e-licktronic/Yocto-V2.0/Eagle/Yocto v2.007.brd

## EAGLE design Eagle/Yocto v2.007.brd (2022-08-23)

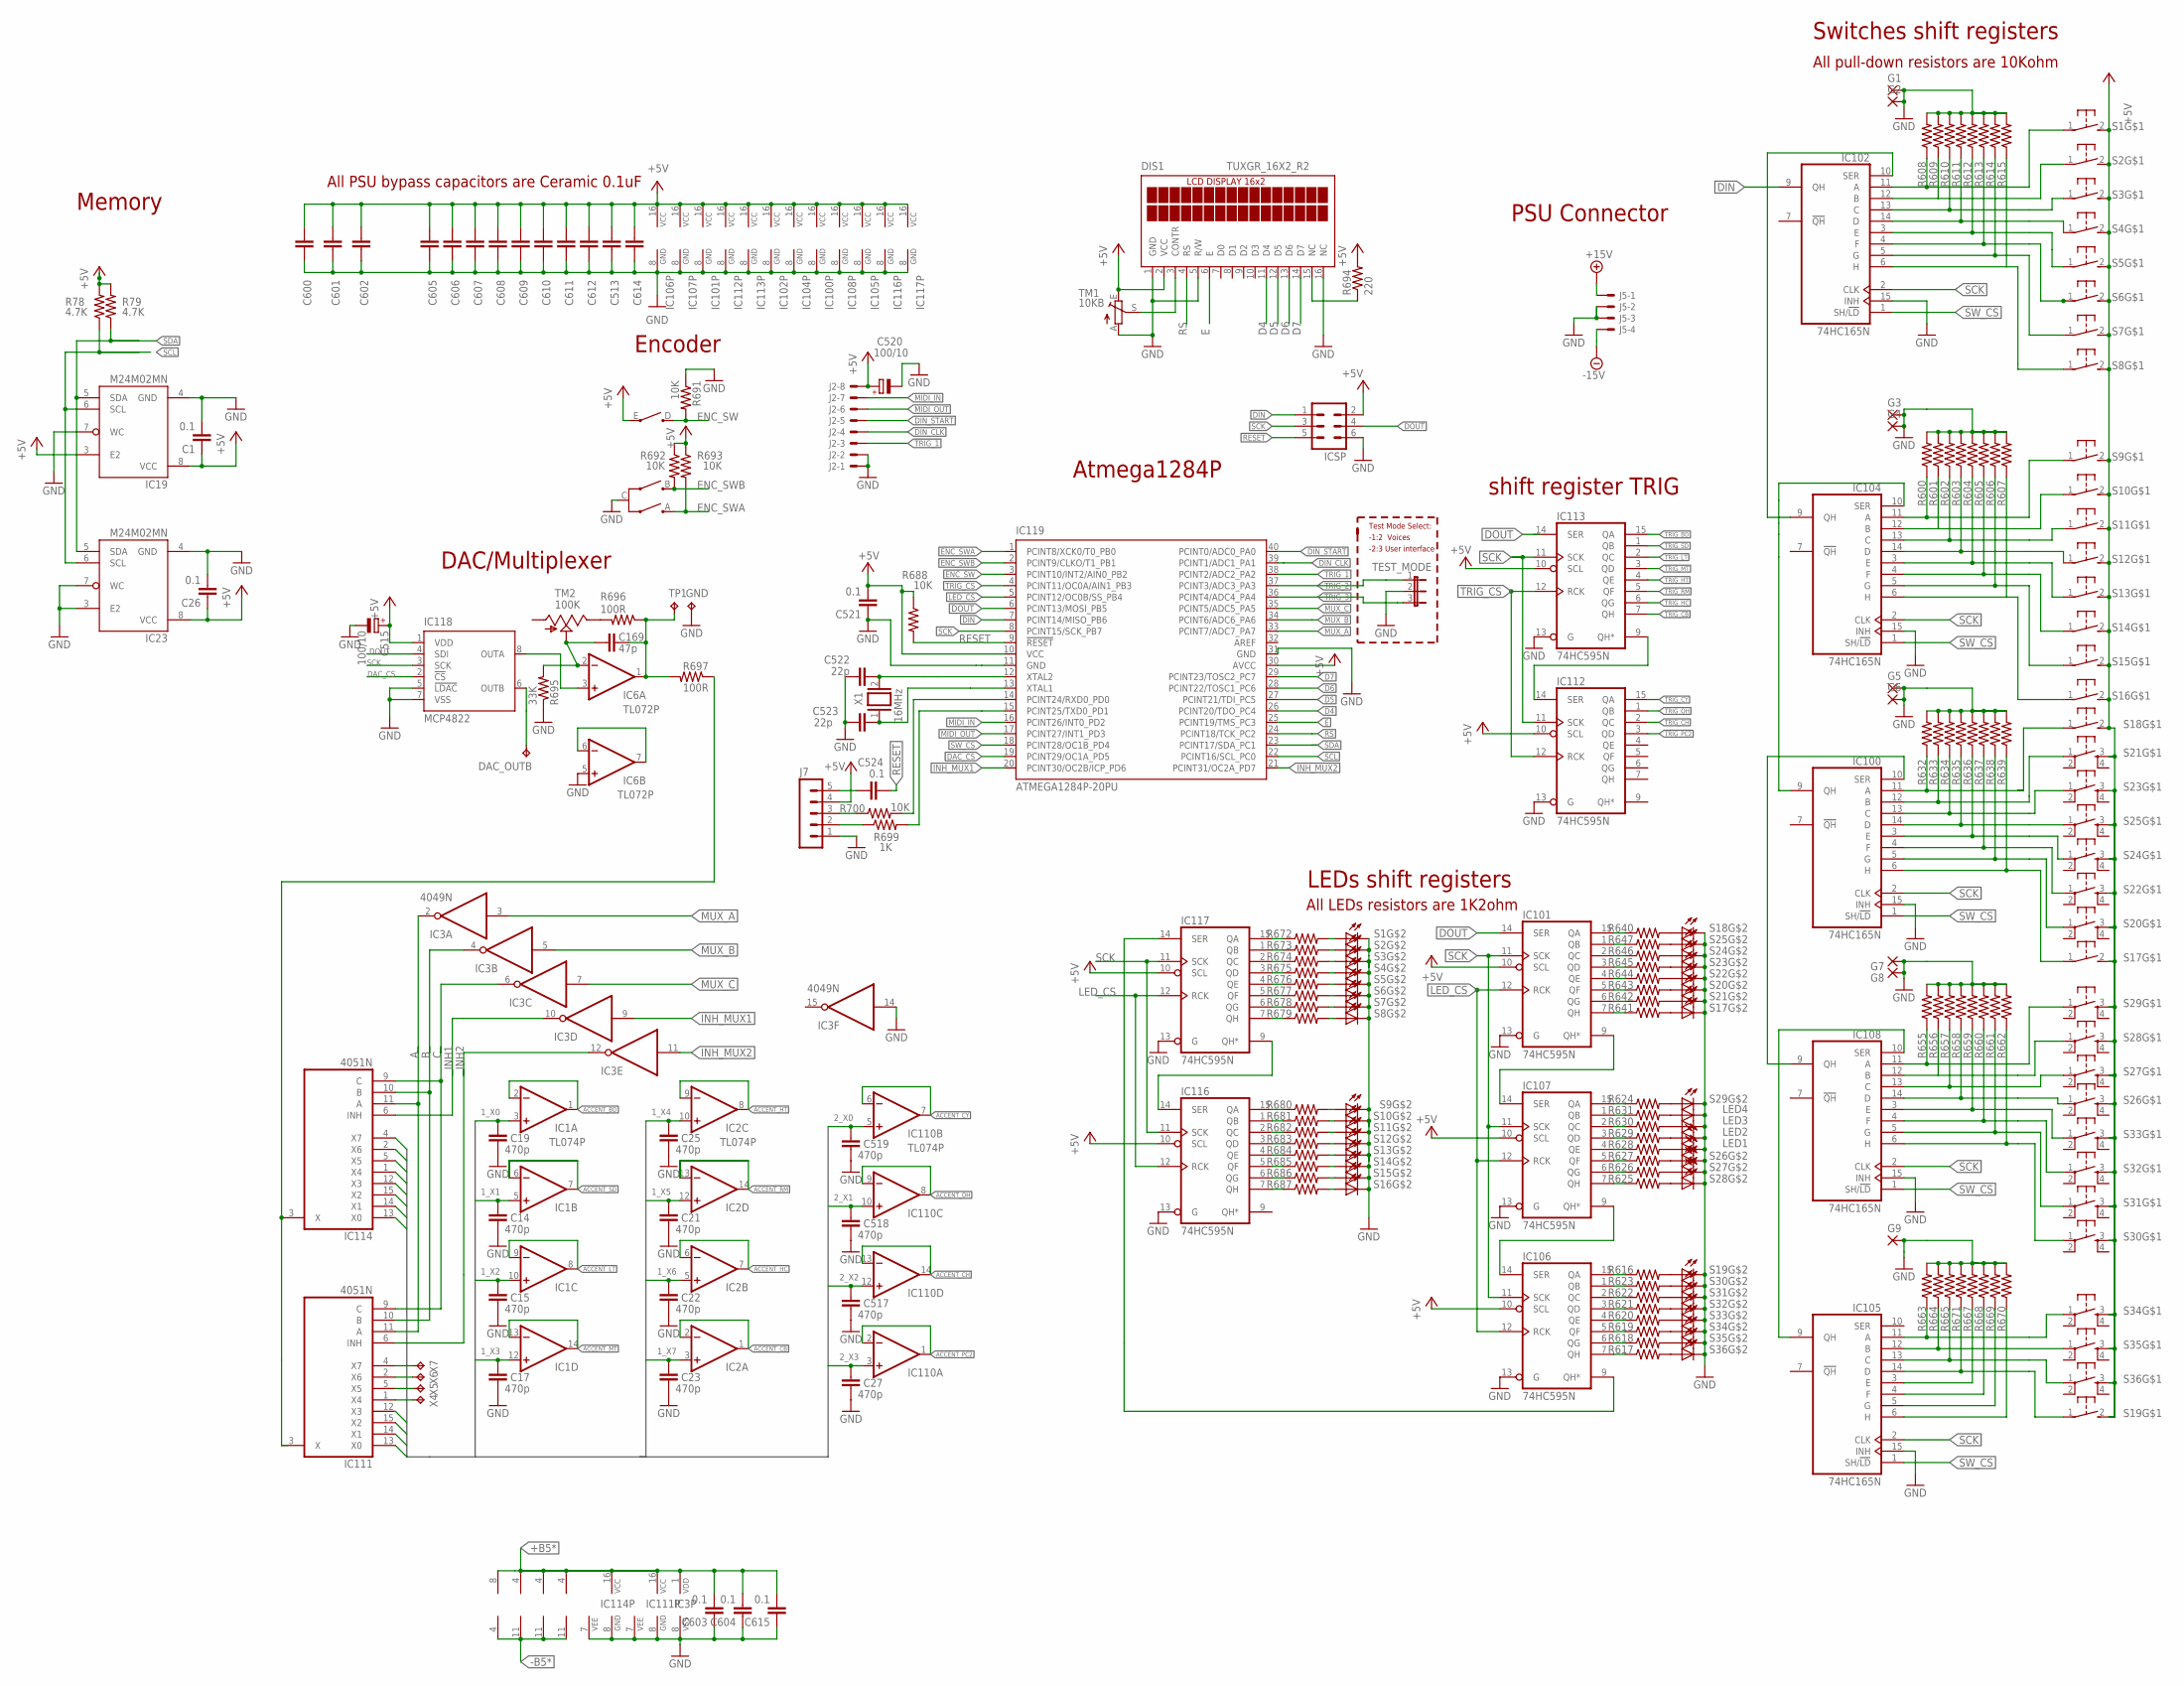
[picture p36: schematic Yocto v2.007.sch, sheet 1, SEQ]

Parts:
C1, C26, C513, C521, C524, C600, C601, C602, C603, C604, C605, C606, C607, C608, C609, C610, C611, C612, C614, C615: 0.1; C050-024X044
C14, C15, C17, C19, C21, C22, C23, C25, C27, C517, C518, C519: 470p; C050-025X075
C169: 47p; C025-025X050
C515, C520: 100/10; E2-5
C522, C523: 22p; C025-025X050
DAC_OUTB: TPB0,8; B0,8
DIS1: TUXGR_16X2_R2
G1, G2, G3, G4, G5, G6, G7, G8, G9: WIREPAD1,6/0,8; 1,6/0,8
GND: TPB0,8; B0,8
IC1, IC2, IC110: TL074P; DIL14
IC3: 4049N; DIL16
IC6: TL072P; DIL08
IC19, IC23: M24M02MN; SO08
IC100, IC102, IC104, IC105, IC108: 74HC165N; DIL16
IC101, IC106, IC107, IC112, IC113, IC116, IC117: 74HC595N; DIL16
IC111, IC114: 4051N; DIL16
IC118: MCP4822; DIL8
IC119: ATMEGA1284P-20PU; DIL40
ICSP: MA03-2
J2: 22-27-2081-08; 6410-08
J5: KK-156-4
J7: MA05-1; MA05-1A
LED1, LED2, LED3, LED4: LED3MM
R78, R79: 4.7K; 0207/7
R600, R601, R602, R603, R604, R605, R606, R607, R608, R609, R610, R611, R612, R613, R614, R615, R632, R633, R634, R635, R636, R637, R638, R639, R655, R656, R657, R658, R659, R660, R661, R662, R663, R664, R665, R667, R668, R669, R670, R671, R688, R691, R692, R693, R700: 10K; 0207/7
R616, R617, R618, R619, R620, R621, R622, R623, R624, R625, R626, R627, R628, R629, R630, R631, R640, R641, R642, R643, R644, R645, R646, R647, R672, R673, R674, R675, R676, R677, R678, R679, R680, R681, R682, R683, R684, R685, R686, R687: 1.2K; 0207/7
R694: 220; 0207/7
R695: 33K; 0207/7
R696, R697: 100R; 0207/7
R699: 1K; 0207/7
S1, S2, S3, S4, S5, S6, S7, S8, S9, S10, S11, S12, S13, S14, S15, S16, S17, S18, S19: MX1A_CHERRY_SW_LED"; MX1A-SW
S20, S21, S22, S23, S24, S25, S26, S27, S28, S29, S30, S31, S32, S33, S34, S35, S36: ZTSN_SW_LED"; SPH_SW
TEST_MODE: JP2E; JP2
TM1: 10KB; CT6
TM2: 100K; S64W
TP1: TPB0,8; B0,8
VR29: PEC16_ENCODER
X1: 16MHz; QS
X4, X5, X6, X7: TPB0,8; B0,8

Connections:
1_X0: C19.1, IC1.3 (+IN), IC114.13 (X0)
1_X1: C14.1, IC1.5 (+IN), IC114.14 (X1)
1_X2: C15.1, IC1.10 (+IN), IC114.15 (X2)
1_X3: C17.1, IC1.12 (+IN), IC114.12 (X3)
1_X4: C25.1, IC2.10 (+IN), IC114.1 (X4)
1_X5: C21.1, IC2.12 (+IN), IC114.5 (X5)
1_X6: C22.1, IC2.5 (+IN), IC114.2 (X6)
1_X7: C23.1, IC2.3 (+IN), IC114.4 (X7)
2_X0: C519.1, IC110.5 (+IN), IC111.13 (X0)
2_X1: C518.1, IC110.10 (+IN), IC111.14 (X1)
2_X2: C517.1, IC110.12 (+IN), IC111.15 (X2)
2_X3: C27.1, IC110.3 (+IN), IC111.12 (X3)
+5V: C1.1, C26.1, C513.2, C515.+, C520.+, C521.2, C600.2, C601.2, C602.2, C605.2, C606.2, C607.2, C608.2, C609.2, C610.2, C611.2, C612.2, C614.2, DIS1.2 (VCC), IC19.3 (E2), IC19.8 (VCC), IC23.8 (VCC), IC100.16 (VCC), IC101.10 (SCL), IC101.16 (VCC), IC102.16 (VCC), IC104.16 (VCC), IC105.16 (VCC), IC106.10 (SCL), IC106.16 (VCC), IC107.10 (SCL), IC107.16 (VCC), IC108.16 (VCC), IC112.10 (SCL), IC112.16 (VCC), IC113.10 (SCL), IC113.16 (VCC), IC116.10 (SCL), IC116.16 (VCC), IC117.10 (SCL), IC117.16 (VCC), IC118.1 (VDD), IC119.10 (VCC), IC119.30 (AVCC), ICSP.2, J2.8, J7.4, R78.2, R79.2, R688.1, R692.1, R693.1, R694.2, S1.2 (S), S2.2 (S), S3.2 (S), S4.2 (S), S5.2 (S), S6.2 (S), S7.2 (S), S8.2 (S), S9.2 (S), S10.2 (S), S11.2 (S), S12.2 (S), S13.2 (S), S14.2 (S), S15.2 (S), S16.2 (S), S17.2 (S), S18.2 (S), S19.2 (S), S20.3 (S), S21.3 (S), S22.3 (S), S23.3 (S), S24.3 (S), S25.3 (S), S26.3 (S), S27.3 (S), S28.3 (S), S29.3 (S), S30.3 (S), S31.3 (S), S32.3 (S), S33.3 (S), S34.3 (S), S35.3 (S), S36.3 (S), TM1.E, VR29.E; also elsewhere on the board
+15V: J5.1; also elsewhere on the board
+B5*: C603.2, C604.2, C615.2, IC1.4 (V+), IC2.4 (V+), IC3.1 (VDD), IC6.8 (V+), IC110.4 (V+), IC111.16 (VCC), IC114.16 (VCC); also elsewhere on the board
-15V: J5.4; also elsewhere on the board
-B5*: IC1.11 (V-), IC2.11 (V-), IC6.4 (V-), IC110.11 (V-); also elsewhere on the board
A: IC3.2 (O), IC111.11 (A), IC114.11 (A)
ACCENT_BD: IC1.1 (OUT), IC1.2 (-IN); also elsewhere on the board
ACCENT_CB: IC2.1 (OUT), IC2.2 (-IN); also elsewhere on the board
ACCENT_CH: IC110.13 (-IN), IC110.14 (OUT); also elsewhere on the board
ACCENT_CY: IC110.6 (-IN), IC110.7 (OUT); also elsewhere on the board
ACCENT_HC: IC2.6 (-IN), IC2.7 (OUT); also elsewhere on the board
ACCENT_HT: IC2.8 (OUT), IC2.9 (-IN); also elsewhere on the board
ACCENT_LT: IC1.8 (OUT), IC1.9 (-IN); also elsewhere on the board
ACCENT_MT: IC1.13 (-IN), IC1.14 (OUT); also elsewhere on the board
ACCENT_OH: IC110.8 (OUT), IC110.9 (-IN); also elsewhere on the board
ACCENT_PC2: IC110.1 (OUT), IC110.2 (-IN); also elsewhere on the board
ACCENT_RM: IC2.13 (-IN), IC2.14 (OUT); also elsewhere on the board
ACCENT_SD: IC1.6 (-IN), IC1.7 (OUT); also elsewhere on the board
B: IC3.4 (O), IC111.10 (B), IC114.10 (B)
C: IC3.6 (O), IC111.9 (C), IC114.9 (C)
D4: DIS1.11 (D4), IC119.26 (PCINT20/TDO_PC4)
D5: DIS1.12 (D5), IC119.27 (PCINT21/TDI_PC5)
D6: DIS1.13 (D6), IC119.28 (PCINT22/TOSC1_PC6)
D7: DIS1.14 (D7), IC119.29 (PCINT23/TOSC2_PC7)
DAC_CS: IC118.2 (!CS!), IC119.19 (PCINT29/OC1A_PD5)
DIN: IC102.9 (QH), IC119.7 (PCINT14/MISO_PB6), ICSP.1
DIN_CLK: IC119.39 (PCINT1/ADC1_PA1), J2.4
DIN_START: IC119.40 (PCINT0/ADC0_PA0), J2.5
DOUT: IC101.14 (SER), IC113.14 (SER), IC118.4 (SDI), IC119.6 (PCINT13/MOSI_PB5), ICSP.4
E: DIS1.6 (E), IC119.25 (PCINT19/TMS_PC3)
ENC_SW: IC119.3 (PCINT10/INT2/AIN0_PB2), R691.2, VR29.D
ENC_SWA: IC119.1 (PCINT8/XCK0/T0_PB0), R693.2, VR29.A
ENC_SWB: IC119.2 (PCINT9/CLKO/T1_PB1), R692.2, VR29.B
GND: C1.2, C14.2, C15.2, C17.2, C19.2, C21.2, C22.2, C23.2, C25.2, C26.2, C27.2, C513.1, C515.-, C517.2, C518.2, C519.2, C520.-, C521.1, C522.1, C523.1, C600.1, C601.1, C602.1, C603.1, C604.1, C605.1, C606.1, C607.1, C608.1, C609.1, C610.1, C611.1, C612.1, C614.1, C615.1, DIS1.1 (GND), DIS1.5 (R/W), DIS1.16 (NC), G1.1, G2.1, G3.1, G4.1, G5.1, G6.1, G7.1, G8.1, G9.1, GND.P$1, IC3.8 (VSS), IC3.14 (I), IC6.5 (+IN), IC19.4 (GND), IC19.7 (WC), IC23.3 (E2), IC23.4 (GND), IC23.7 (WC), IC100.8 (GND), IC100.15 (INH), IC101.8 (GND), IC101.13 (G), IC102.8 (GND), IC102.15 (INH), IC104.8 (GND), IC104.15 (INH), IC105.8 (GND), IC105.15 (INH), IC106.8 (GND), IC106.13 (G), IC107.8 (GND), IC107.13 (G), IC108.8 (GND), IC108.15 (INH), IC111.7 (VEE), IC111.8 (GND), IC112.8 (GND), IC112.13 (G), IC113.8 (GND), IC113.13 (G), IC114.7 (VEE), IC114.8 (GND), IC116.8 (GND), IC116.13 (G), IC117.8 (GND), IC117.13 (G), IC118.5 (!LDAC!), IC118.7 (VSS), IC119.11 (GND), IC119.31 (GND), ICSP.6, J2.1, J2.2, J5.2, J5.3, J7.1, LED1.K (C), LED2.K (C), LED3.K (C), LED4.K (C), R600.2, R601.2, R602.2, R603.2, R604.2, R605.2, R606.2, R607.2, R608.2, R609.2, R610.2, R611.2, R612.2, R613.2, R614.2, R615.2, R632.2, R633.2, R634.2, R635.2, R636.2, R637.2, R638.2, R639.2, R655.2, R656.2, R657.2, R658.2, R659.2, R660.2, R661.2, R662.2, R663.2, R664.2, R665.2, R667.2, R668.2, R669.2, R670.2, R671.2, R691.1, R695.1, S1.K (C), S2.K (C), S3.K (C), S4.K (C), S5.K (C), S6.K (C), S7.K (C), S8.K (C), S9.K (C), S10.K (C), S11.K (C), S12.K (C), S13.K (C), S14.K (C), S15.K (C), S16.K (C), S17.K (C), S18.K (C), S19.K (C), S20.K (C), S21.K (C), S22.K (C), S23.K (C), S24.K (C), S25.K (C), S26.K (C), S27.K (C), S28.K (C), S29.K (C), S30.K (C), S31.K (C), S32.K (C), S33.K (C), S34.K (C), S35.K (C), S36.K (C), TEST_MODE.2, TM1.A, VR29.C; also elsewhere on the board
INH1: IC3.10 (O), IC114.6 (INH)
INH2: IC3.12 (O), IC111.6 (INH)
INH_MUX1: IC3.9 (I), IC119.20 (PCINT30/OC2B/ICP_PD6)
INH_MUX2: IC3.11 (I), IC119.21 (PCINT31/OC2A_PD7)
LED_CS: IC101.12 (RCK), IC106.12 (RCK), IC107.12 (RCK), IC116.12 (RCK), IC117.12 (RCK), IC119.5 (PCINT12/OC0B/SS_PB4)
MIDI_IN: IC119.16 (PCINT26/INT0_PD2), J2.7
MIDI_OUT: IC119.17 (PCINT27/INT1_PD3), J2.6
MUX_A: IC3.3 (I), IC119.33 (PCINT7/ADC7_PA7)
MUX_B: IC3.5 (I), IC119.34 (PCINT6/ADC6_PA6)
MUX_C: IC3.7 (I), IC119.35 (PCINT5/ADC5_PA5)
unnamed: R624.2, S29.A
unnamed: R625.2, S28.A
unnamed: R626.2, S27.A
unnamed: R627.2, S26.A
unnamed: R647.2, S25.A
unnamed: R646.2, S24.A
unnamed: R645.2, S23.A
unnamed: R644.2, S22.A
unnamed: R642.2, S21.A
unnamed: R643.2, S20.A
unnamed: R640.2, S18.A
unnamed: R641.2, S17.A
unnamed: LED4.A, R631.2
unnamed: LED3.A, R630.2
unnamed: LED2.A, R629.2
unnamed: LED1.A, R628.2
unnamed: R616.2, S19.A
unnamed: R617.2, S36.A
unnamed: R618.2, S35.A
unnamed: R619.2, S34.A
unnamed: R620.2, S33.A
unnamed: R621.2, S32.A
unnamed: R622.2, S31.A
unnamed: R623.2, S30.A
unnamed: IC108.14 (D), R658.1, S26.1
unnamed: IC6.3 (+IN), IC118.8 (OUTA)
unnamed: IC117.15 (QA), R672.1
unnamed: IC117.1 (QB), R673.1
unnamed: IC117.2 (QC), R674.1
unnamed: IC117.3 (QD), R675.1
unnamed: IC117.4 (QE), R676.1
unnamed: IC117.5 (QF), R677.1
unnamed: IC117.6 (QG), R678.1
unnamed: IC117.7 (QH), R679.1
unnamed: IC116.14 (SER), IC117.9 (QH*)
unnamed: IC116.15 (QA), R680.1
unnamed: IC116.1 (QB), R681.1
unnamed: IC116.2 (QC), R682.1
unnamed: IC116.3 (QD), R683.1
unnamed: IC116.4 (QE), R684.1
unnamed: IC116.5 (QF), R685.1
unnamed: IC116.6 (QG), R686.1
unnamed: IC116.7 (QH), R687.1
unnamed: R680.2, S9.A
unnamed: R681.2, S10.A
unnamed: R682.2, S11.A
unnamed: R683.2, S12.A
unnamed: R684.2, S13.A
unnamed: R685.2, S14.A
unnamed: R686.2, S15.A
unnamed: R687.2, S16.A
unnamed: R672.2, S1.A
unnamed: R673.2, S2.A
unnamed: R674.2, S3.A
unnamed: R675.2, S4.A
unnamed: R676.2, S5.A
unnamed: R677.2, S6.A
unnamed: R678.2, S7.A
unnamed: R679.2, S8.A
unnamed: IC106.9 (QH*), IC117.14 (SER)
unnamed: IC6.6 (-IN), IC6.7 (OUT)
unnamed: IC119.15 (PCINT25/TXD0_PD1), R699.2
unnamed: IC119.14 (PCINT24/RXD0_PD0), R700.2
unnamed: IC112.14 (SER), IC113.9 (QH*)
unnamed: C522.2, IC119.12 (XTAL2), X1.2
unnamed: C523.2, IC119.13 (XTAL1), X1.1
unnamed: IC111.1 (X4), X4.P$1
unnamed: IC111.5 (X5), X5.P$1
unnamed: IC111.2 (X6), X6.P$1
unnamed: IC111.4 (X7), X7.P$1
unnamed: IC102.11 (A), R608.1, S1.1
unnamed: IC102.12 (B), R609.1, S2.1
unnamed: IC102.13 (C), R610.1, S3.1
unnamed: IC102.14 (D), R611.1, S4.1
unnamed: IC102.3 (E), R612.1, S5.1
unnamed: IC102.4 (F), R613.1, S6.1
unnamed: IC102.5 (G), R614.1, S7.1
unnamed: IC102.6 (H), R615.1, S8.1
unnamed: IC104.11 (A), R600.1, S9.1
unnamed: IC104.12 (B), R601.1, S10.1
unnamed: IC104.13 (C), R602.1, S11.1
unnamed: IC104.14 (D), R603.1, S12.1
unnamed: IC104.3 (E), R604.1, S13.1
unnamed: IC104.4 (F), R605.1, S14.1
unnamed: IC104.5 (G), R606.1, S15.1
unnamed: IC104.6 (H), R607.1, S16.1
unnamed: IC100.11 (A), R632.1, S18.1
unnamed: IC100.12 (B), R633.1, S21.1
unnamed: IC100.13 (C), R634.1, S23.1
unnamed: IC100.14 (D), R635.1, S25.1
unnamed: IC100.3 (E), R636.1, S24.1
unnamed: IC100.4 (F), R637.1, S22.1
unnamed: IC100.5 (G), R638.1, S20.1
unnamed: IC102.10 (SER), IC104.9 (QH)
unnamed: IC100.9 (QH), IC104.10 (SER)
unnamed: IC100.6 (H), R639.1, S17.1
unnamed: IC111.3 (X), IC114.3 (X), R697.1
unnamed: IC101.15 (QA), R640.1
unnamed: IC100.10 (SER), IC108.9 (QH)
unnamed: IC108.11 (A), R655.1, S29.1
unnamed: IC108.12 (B), R656.1, S28.1
unnamed: IC108.13 (C), R657.1, S27.1
unnamed: IC108.3 (E), R659.1, S33.1
unnamed: IC108.4 (F), R660.1, S32.1
unnamed: IC108.5 (G), R661.1, S31.1
unnamed: IC108.6 (H), R662.1, S30.1
unnamed: IC101.1 (QB), R647.1
unnamed: IC105.9 (QH), IC108.10 (SER)
unnamed: IC101.2 (QC), R646.1
unnamed: IC105.11 (A), R663.1, S34.1
unnamed: IC105.12 (B), R664.1, S35.1
unnamed: IC105.13 (C), R665.1, S36.1
unnamed: IC105.14 (D), R671.1, S19.1
unnamed: IC105.3 (E), R667.1
unnamed: IC105.4 (F), R668.1
unnamed: IC105.5 (G), R669.1
unnamed: IC105.6 (H), R670.1
unnamed: IC101.3 (QD), R645.1
unnamed: IC101.4 (QE), R644.1
unnamed: IC101.5 (QF), R643.1
unnamed: IC101.6 (QG), R642.1
unnamed: IC101.7 (QH), R641.1
unnamed: IC107.15 (QA), R624.1
unnamed: IC107.1 (QB), R631.1
unnamed: IC107.2 (QC), R630.1
unnamed: IC107.3 (QD), R629.1
unnamed: IC107.4 (QE), R628.1
unnamed: IC107.5 (QF), R627.1
unnamed: IC107.6 (QG), R626.1
unnamed: IC107.7 (QH), R625.1
unnamed: IC101.9 (QH*), IC107.14 (SER)
unnamed: IC106.14 (SER), IC107.9 (QH*)
unnamed: IC106.15 (QA), R616.1
unnamed: IC106.1 (QB), R623.1
unnamed: IC106.2 (QC), R622.1
unnamed: IC106.3 (QD), R621.1
unnamed: IC106.4 (QE), R620.1
unnamed: IC106.5 (QF), R619.1
unnamed: IC106.6 (QG), R618.1
unnamed: IC106.7 (QH), R617.1
unnamed: R696.2, TM2.E
unnamed: C169.2, IC6.1 (OUT), R696.1, R697.2, TP1.P$1
unnamed: C169.1, IC6.2 (-IN), R695.2, TM2.S
unnamed: DIS1.15 (NC), R694.1
unnamed: DIS1.3 (CONTR), TM1.S
unnamed: C524.2, J7.5
unnamed: J7.3, R700.1
unnamed: J7.2, R699.1
RESET: C524.1, IC119.9 (!RESET), ICSP.5, R688.2
RS: DIS1.4 (RS), IC119.24 (PCINT18/TCK_PC2)
SCK: IC100.2 (CLK), IC101.11 (SCK), IC102.2 (CLK), IC104.2 (CLK), IC105.2 (CLK), IC106.11 (SCK), IC107.11 (SCK), IC108.2 (CLK), IC112.11 (SCK), IC113.11 (SCK), IC116.11 (SCK), IC117.11 (SCK), IC118.3 (SCK), IC119.8 (PCINT15/SCK_PB7), ICSP.3
SCL: IC19.6 (SCL), IC23.6 (SCL), IC119.22 (PCINT16/SCL_PC0), R78.1
SDA: IC19.5 (SDA), IC23.5 (SDA), IC119.23 (PCINT17/SDA_PC1), R79.1
SW_CS: IC100.1 (SH/!LD), IC102.1 (SH/!LD), IC104.1 (SH/!LD), IC105.1 (SH/!LD), IC108.1 (SH/!LD), IC119.18 (PCINT28/OC1B_PD4)
TRIG_1: IC119.38 (PCINT2/ADC2_PA2), J2.3
TRIG_2: IC119.37 (PCINT3/ADC3_PA3), TEST_MODE.1
TRIG_3: IC119.36 (PCINT4/ADC4_PA4), TEST_MODE.3
TRIG_BD: IC113.15 (QA); also elsewhere on the board
TRIG_CB: IC113.7 (QH); also elsewhere on the board
TRIG_CH: IC112.2 (QC); also elsewhere on the board
TRIG_CS: IC112.12 (RCK), IC113.12 (RCK), IC119.4 (PCINT11/OC0A/AIN1_PB3)
TRIG_CY: IC112.15 (QA); also elsewhere on the board
TRIG_HC: IC113.6 (QG); also elsewhere on the board
TRIG_HT: IC113.4 (QE); also elsewhere on the board
TRIG_LT: IC113.2 (QC); also elsewhere on the board
TRIG_MT: IC113.3 (QD); also elsewhere on the board
TRIG_OH: IC112.1 (QB); also elsewhere on the board
TRIG_PC2: IC112.3 (QD); also elsewhere on the board
TRIG_RM: IC113.5 (QF); also elsewhere on the board
TRIG_SD: IC113.1 (QB); also elsewhere on the board
WN1: DAC_OUTB.P$1, IC118.6 (OUTB)

Notes on the sheet:
Memory
Encoder
Atmega1284P
DAC/Multiplexer
LEDs shift registers
shift register TRIG
Switches shift registers
PSU Connector
All pull-down resistors are 10Kohm
All PSU bypass capacitors are Ceramic 0.1uF
All LEDs resistors are 1K2ohm
Test Mode Select:
-1:2 Voices
-2:3 User interface

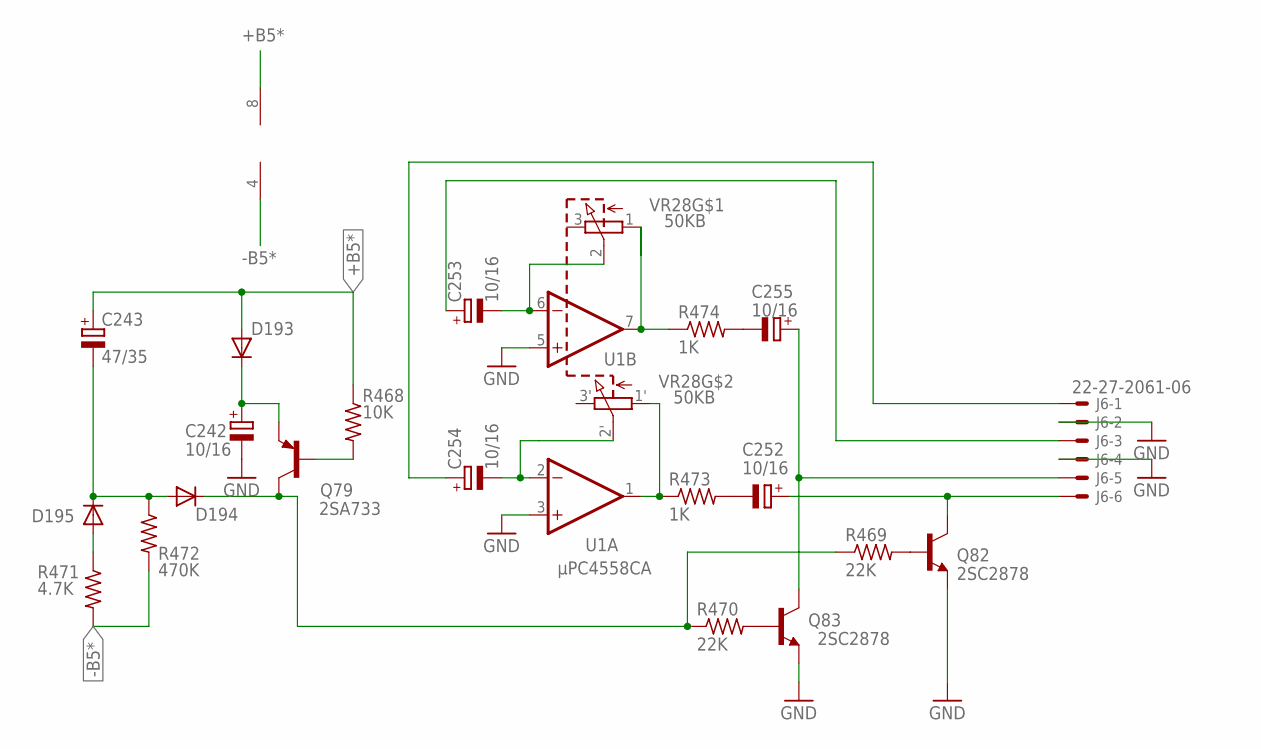
[picture p37: schematic Yocto v2.007.sch, sheet 2, Master]

Parts:
C242, C252, C253, C254, C255: 10/16; E2-5
C243: 47/35; E2,5-6
D193, D194, D195: 1N4148; DO35-7C
J6: 22-27-2061-06; 6410-06
Q79: 2SA733; TO-92-ECB-MARKED
Q82, Q83: 2SC2878; TO92-ECB
R468: 10K; 0207/7
R469, R470: 22K; 0207/7
R471: 4.7K; 0207/7
R472: 470K; 0207/7
R473, R474: 1K; 0207/7
U1: µPC4558CA; DIL08
VR28: 50KB; PTV112-4

Connections:
+B5*: C243.+, D193.A, R468.1, U1.8 (V+); also elsewhere on the board
-B5*: R471.2, R472.2, U1.4 (V-); also elsewhere on the board
GND: C242.-, J6.2, J6.4, Q82.E, Q83.E, U1.3 (+IN), U1.5 (+IN); also elsewhere on the board
unnamed: D195.A, R471.1
unnamed: C243.-, D194.A, D195.C, R472.1
unnamed: R474.1, U1.7 (OUT), VR28.1
unnamed: R473.1, U1.1 (OUT), VR28.1' (1)
unnamed: D194.C, Q79.C, R469.1, R470.1
unnamed: C242.+, D193.C, Q79.E
unnamed: Q79.B, R468.2
unnamed: C254.-, U1.2 (-IN), VR28.2' (2)
unnamed: C253.-, U1.6 (-IN), VR28.2
unnamed: C255.-, R474.2
unnamed: C252.-, R473.2
unnamed: Q82.B, R469.2
unnamed: Q83.B, R470.2
unnamed: C253.+, J6.3
unnamed: C255.+, J6.5, Q83.C
unnamed: C252.+, J6.6, Q82.C
unnamed: C254.+, J6.1

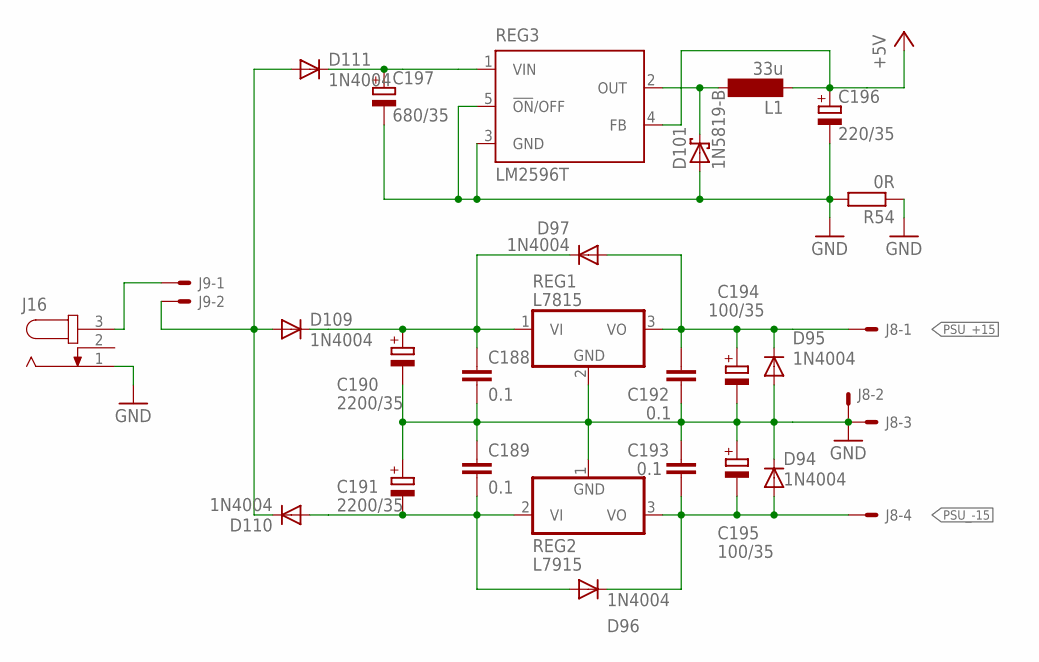
[picture p38: schematic Yocto v2.007.sch, sheet 3, PSU]

Parts:
C188, C189, C192, C193: 0.1; C050-024X044
C190, C191: 2200/35; E7,5-16
C194, C195: 100/35; E3,5-8
C196: 220/35; E3,5-8
C197: 680/35; E5-13
D94, D95, D96, D97, D109, D110, D111: 1N4004; DO41-7
D101: 1N5819-B; DO41-7.6
J8: KK-156-4
J9: KK-156-2
J16: JACK-PLUG0; JACK_PSU_2.1MM
L1: 33u; BS11
R54: 0R; 0207/7
REG1: L7815; TO220V
REG2: L7915; TO220V
REG3: LM2596T; T05D

Connections:
+5V: C196.+, L1.1, REG3.4 (FB); also elsewhere on the board
GND: C188.2, C189.1, C190.-, C191.+, C192.2, C193.1, C194.-, C195.+, C196.-, C197.-, D94.C, D95.A, D101.A, J8.2, J8.3, J16.1, R54.1, R54.2, REG1.2 (GND), REG2.1 (GND), REG3.3 (GND), REG3.5 (!ON!/OFF); also elsewhere on the board
unnamed: C189.2, C191.-, D96.A, D110.A, REG2.2 (VI)
unnamed: C188.1, C190.+, D97.C, D109.C, REG1.1 (VI)
unnamed: D109.A, D110.C, D111.A, J9.2
unnamed: C197.+, D111.C, REG3.1 (VIN)
unnamed: D101.C, L1.2, REG3.2 (OUT)
unnamed: J9.1, J16.3
PSU_+15: C192.1, C194.+, D95.C, D97.A, J8.1, REG1.3 (VO); also elsewhere on the board
PSU_-15: C193.2, C195.-, D94.A, D96.C, J8.4, REG2.3 (VO); also elsewhere on the board

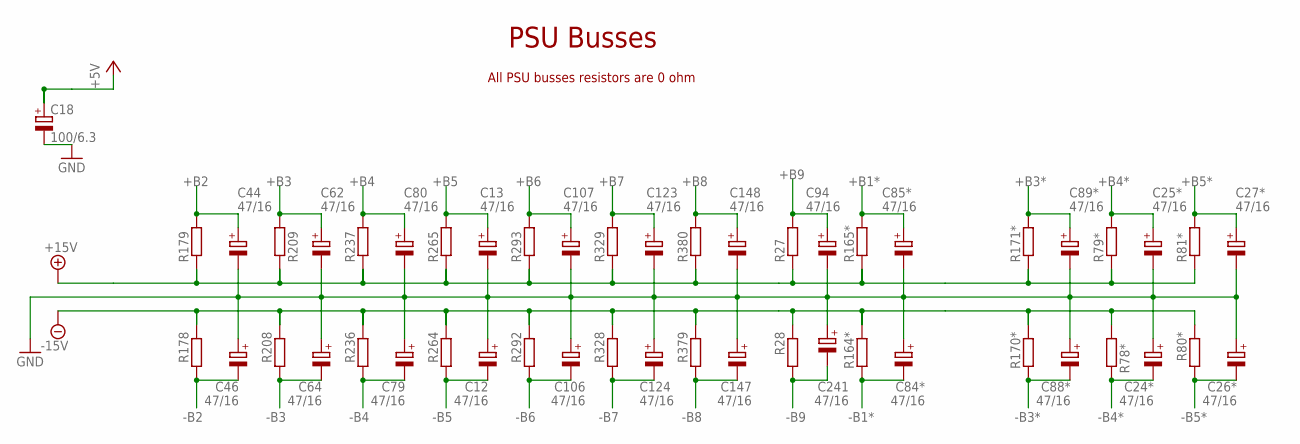
[picture p39: schematic Yocto v2.007.sch, sheet 4, PSU BUSS]

Parts:
C12, C13, C24*, C25*, C26*, C27*, C44, C46, C62, C64, C79, C80, C84*, C85*, C88*, C89*, C94, C106, C107, C123, C124, C147, C148, C241: 47/16; E2,5-6
C18: 100/6.3; E2-5
R27, R28, R78*, R79*, R80*, R81*, R164*, R165*, R170*, R171*, R178, R179, R208, R209, R236, R237, R264, R265, R292, R293, R328, R329, R379, R380: 0R; 0207/7

Connections:
+5V: C18.+; also elsewhere on the board
+15V: R27.1, R79*.1, R81*.1, R165*.1, R171*.1, R179.1, R209.1, R237.1, R265.1, R293.1, R329.1, R380.1; also elsewhere on the board
+B1*: C85*.+, R165*.2; also elsewhere on the board
+B2: C44.+, R179.2; also elsewhere on the board
+B3: C62.+, R209.2; also elsewhere on the board
+B3*: C89*.+, R171*.2; also elsewhere on the board
+B4: C80.+, R237.2; also elsewhere on the board
+B4*: C25*.+, R79*.2; also elsewhere on the board
+B5: C13.+, R265.2; also elsewhere on the board
+B5*: C27*.+, R81*.2; also elsewhere on the board
+B6: C107.+, R293.2; also elsewhere on the board
+B7: C123.+, R329.2; also elsewhere on the board
+B8: C148.+, R380.2; also elsewhere on the board
+B9: C94.+, R27.2; also elsewhere on the board
-15V: R28.1, R78*.2, R80*.1, R164*.1, R170*.1, R178.1, R208.1, R236.1, R264.1, R292.1, R328.1, R379.1; also elsewhere on the board
-B1*: C84*.-, R164*.2; also elsewhere on the board
-B2: C46.-, R178.2; also elsewhere on the board
-B3: C64.-, R208.2; also elsewhere on the board
-B3*: C88*.-, R170*.2; also elsewhere on the board
-B4: C79.-, R236.2; also elsewhere on the board
-B4*: C24*.-, R78*.1; also elsewhere on the board
-B5: C12.-, R264.2; also elsewhere on the board
-B5*: C26*.-, R80*.2; also elsewhere on the board
-B6: C106.-, R292.2; also elsewhere on the board
-B7: C124.-, R328.2; also elsewhere on the board
-B8: C147.-, R379.2; also elsewhere on the board
-B9: C241.-, R28.2; also elsewhere on the board
GND: C12.+, C13.-, C18.-, C24*.+, C25*.-, C26*.+, C27*.-, C44.-, C46.+, C62.-, C64.+, C79.+, C80.-, C84*.+, C85*.-, C88*.+, C89*.-, C94.-, C106.+, C107.-, C123.-, C124.+, C147.+, C148.-, C241.+; also elsewhere on the board

Notes on the sheet:
PSU Busses
All PSU busses resistors are 0 ohm

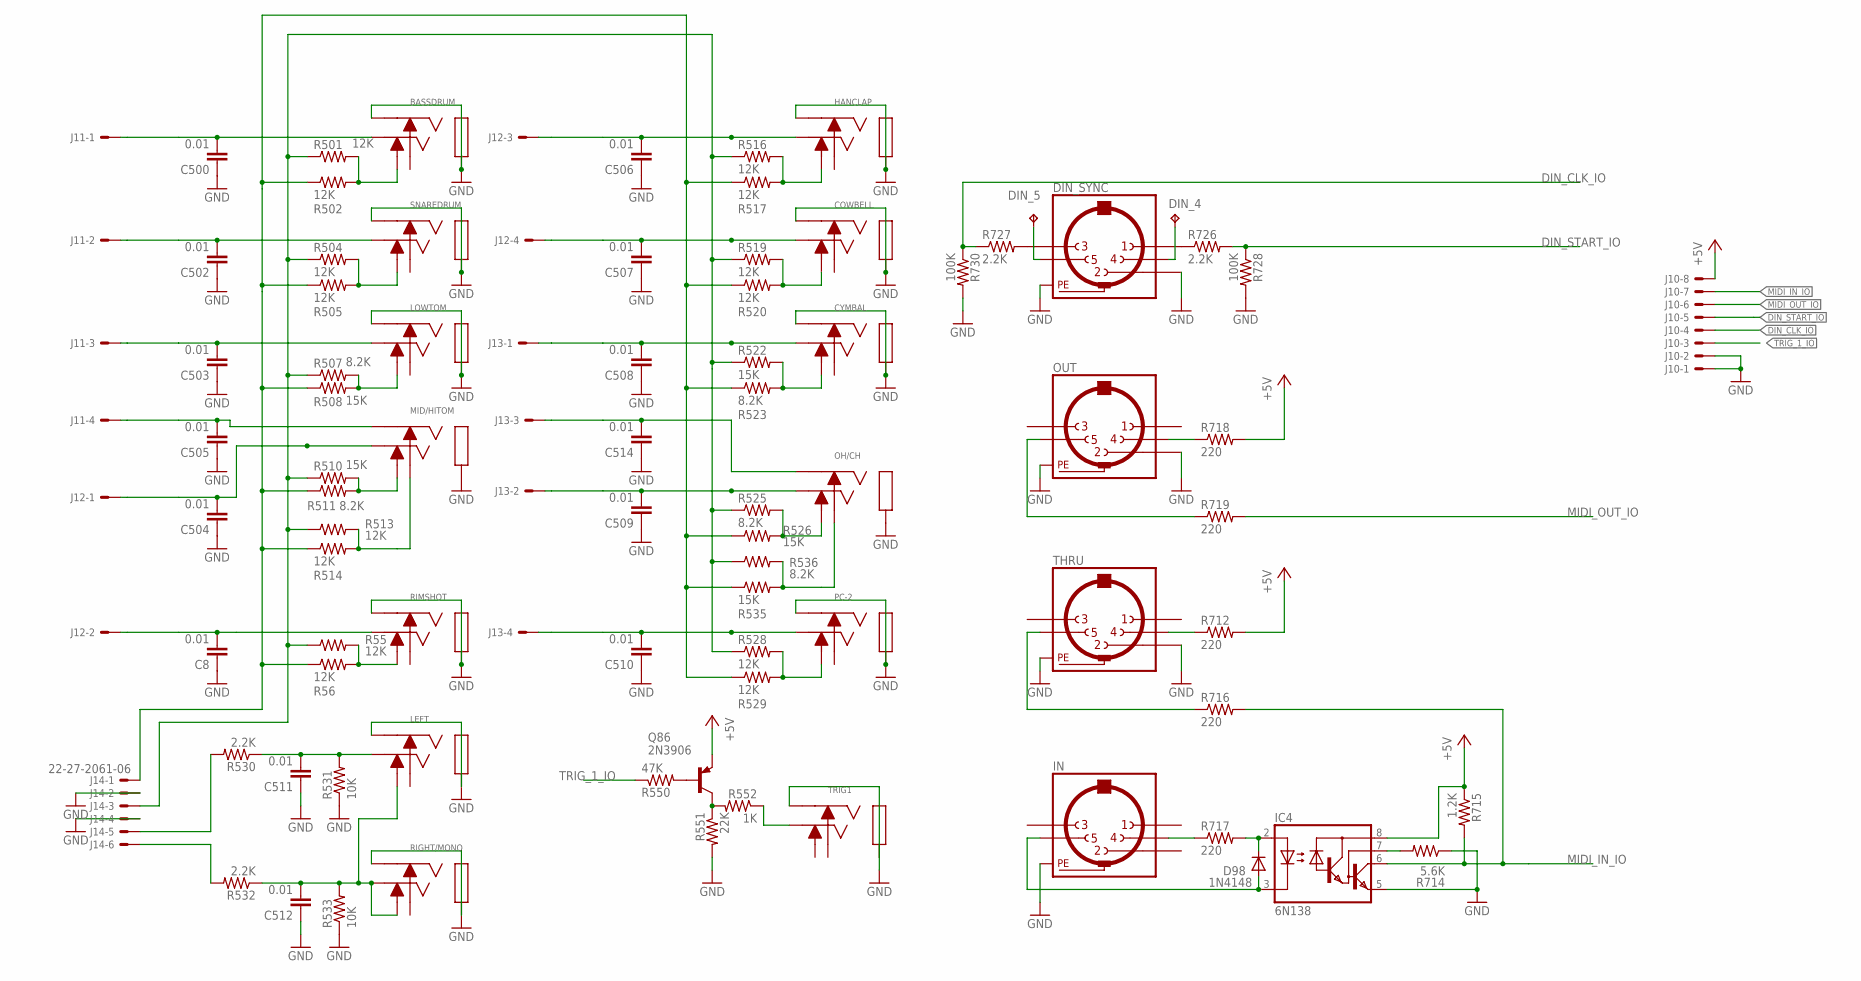
[picture p40: schematic Yocto v2.007.sch, sheet 5, IO]

Parts:
BASSDRUM: JACK_TRSNRJ6HF; JACK_TRS
C8, C500, C502, C503, C504, C505, C506, C507, C508, C509, C510, C511, C512, C514: 0.01; C050-025X075
COWBELL: JACK_TRSNRJ6HF; JACK_TRS
CYMBAL: JACK_TRSNRJ6HF; JACK_TRS
D98: 1N4148; DO35-7C
DIN_4, DIN_5: TPB0,8; B0,8
DIN_SYNC: MAB5SH
HANCLAP: JACK_TRSNRJ6HF; JACK_TRS
IC4: 6N138; DIL08
IN: MAB5SH
J10: 22-27-2081-08; 6410-08
J11, J12, J13: 22-27-2041-04; 6410-04
J14: 22-27-2061-06; 6410-06
LEFT: JACK_TRSNRJ6HF; JACK_TRS
LOWTOM: JACK_TRSNRJ6HF; JACK_TRS
MID/HITOM: JACK_TRSNRJ6HF; JACK_TRS
OH/CH: JACK_TRSNRJ6HF; JACK_TRS
OUT: MAB5SH
PC-2: JACK_TRSNRJ6HF; JACK_TRS
Q86: 2N3906; TO92-EBC-SMALL
R55, R56, R501, R502, R504, R505, R513, R514, R516, R517, R519, R520, R528, R529: 12K; 0207/7
R507, R511, R523, R525, R536: 8.2K; 0207/7
R508, R510, R522, R526, R535: 15K; 0207/7
R530, R532, R726, R727: 2.2K; 0207/7
R531, R533: 10K; 0207/7
R550: 47K; 0207/7
R551: 22K; 0207/7
R552: 1K; 0207/7
R712, R716, R717, R718, R719: 220; 0207/7
R714: 5.6K; 0207/7
R715: 1.2K; 0207/7
R728, R730: 100K; 0207/7
RIGHT/MONO: JACK_TRSNRJ6HF; JACK_TRS
RIMSHOT: JACK_TRSNRJ6HF; JACK_TRS
SNAREDRUM: JACK_TRSNRJ6HF; JACK_TRS
THRU: MAB5SH
TRIG1: JACK_TRSNRJ6HF; JACK_TRS

Connections:
+5V: IC4.8 (VCC), J10.8, Q86.E, R712.2, R715.1, R718.2; also elsewhere on the board
DIN_CLK_IO: J10.4, R727.1, R730.1
DIN_START_IO: J10.5, R726.2, R728.1
GND: BASSDRUM.R, BASSDRUM.S, C8.1, C500.1, C502.1, C503.1, C504.1, C505.1, C506.1, C507.1, C508.1, C509.1, C510.1, C511.1, C512.1, C514.1, COWBELL.R, COWBELL.S, CYMBAL.R, CYMBAL.S, DIN_SYNC.2, DIN_SYNC.PE, DIN_SYNC.PE@ (PE), HANCLAP.R, HANCLAP.S, IC4.5 (GND), IN.PE, IN.PE@ (PE), J10.1, J10.2, J14.2, J14.4, LEFT.R, LEFT.S, LOWTOM.R, LOWTOM.S, MID/HITOM.S, OH/CH.S, OUT.2, OUT.PE, OUT.PE@ (PE), PC-2.R, PC-2.S, R531.1, R533.1, R551.2, R714.1, R728.2, R730.2, RIGHT/MONO.R, RIGHT/MONO.S, RIMSHOT.R, RIMSHOT.S, SNAREDRUM.R, SNAREDRUM.S, THRU.2, THRU.PE, THRU.PE@ (PE), TRIG1.R, TRIG1.S; also elsewhere on the board
MIDI_IN_IO: IC4.6 (VO), J10.7, R715.2, R716.2
MIDI_OUT_IO: J10.6, R719.2
unnamed: R552.1, TRIG1.T
unnamed: R55.2, R56.2, RIMSHOT.TN
unnamed: C8.2, J12.2, RIMSHOT.T
unnamed: OH/CH.RN, R535.2, R536.2
unnamed: C514.2, J13.3, OH/CH.R
unnamed: DIN_5.P$1, DIN_SYNC.5
unnamed: DIN_4.P$1, DIN_SYNC.4
unnamed: BASSDRUM.TN, R501.2, R502.2
unnamed: BASSDRUM.T, C500.2, J11.1
unnamed: Q86.B, R550.2
unnamed: C512.2, LEFT.TN, R532.1, R533.2, RIGHT/MONO.T, RIGHT/MONO.TN
unnamed: R504.2, R505.2, SNAREDRUM.TN
unnamed: C502.2, J11.2, SNAREDRUM.T
unnamed: C511.2, LEFT.T, R530.1, R531.2
unnamed: LOWTOM.TN, R507.2, R508.2
unnamed: C503.2, J11.3, LOWTOM.T
unnamed: MID/HITOM.TN, R510.2, R511.2
unnamed: C504.2, J12.1, MID/HITOM.T
unnamed: MID/HITOM.RN, R513.2, R514.2
unnamed: C505.2, J11.4, MID/HITOM.R
unnamed: J14.1, R56.1, R502.1, R505.1, R508.1, R511.1, R514.1, R517.1, R520.1, R523.1, R526.1, R529.1, R535.1
unnamed: HANCLAP.TN, R516.2, R517.2
unnamed: C506.2, HANCLAP.T, J12.3
unnamed: COWBELL.TN, R519.2, R520.2
unnamed: IN.4, R717.1
unnamed: D98.C, IC4.2 (A), R717.2
unnamed: D98.A, IC4.3 (C), IN.5
unnamed: R712.1, THRU.4
unnamed: R716.1, THRU.5
unnamed: IC4.7 (VB), R714.2
unnamed: OUT.4, R718.1
unnamed: OUT.5, R719.1
unnamed: DIN_SYNC.1, R726.1
unnamed: DIN_SYNC.3, R727.2
unnamed: C507.2, COWBELL.T, J12.4
unnamed: Q86.C, R551.1, R552.2
unnamed: CYMBAL.TN, R522.2, R523.2
unnamed: C508.2, CYMBAL.T, J13.1
unnamed: J14.5, R530.2
unnamed: J14.6, R532.2
unnamed: OH/CH.TN, R525.2, R526.2
unnamed: C509.2, J13.2, OH/CH.T
unnamed: PC-2.TN, R528.2, R529.2
unnamed: C510.2, J13.4, PC-2.T
unnamed: J14.3, R55.1, R501.1, R504.1, R507.1, R510.1, R513.1, R516.1, R519.1, R522.1, R525.1, R528.1, R536.1
TRIG_1_IO: J10.3, R550.1

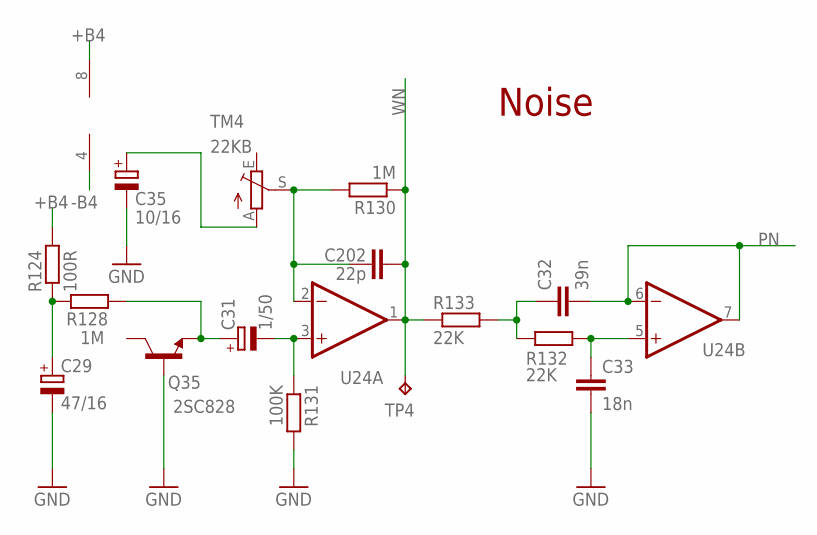
[picture p41: schematic Yocto v2.007.sch, sheet 6, NOISE]

Parts:
C29: 47/16; E2,5-6
C31: 1/50; E2-5
C32: 39n; C050-025X075
C33: 18n; C050-025X075
C35: 10/16; E2-5
C202: 22p; C025-025X050
Q35: 2SC828; TO-ECB-MARKED2
R124: 100R; 0207/7
R128, R130: 1M; 0207/7
R131: 100K; 0207/7
R132, R133: 22K; 0207/7
TM4: 22KB; CT6
TP4: TPB0,8; B0,8
U24: µPC4558CA; DIL08

Connections:
+B4: R124.2, U24.8 (V+); also elsewhere on the board
-B4: U24.4 (V-); also elsewhere on the board
GND: C29.-, C33.2, C35.-, Q35.B, R131.2; also elsewhere on the board
unnamed: C35.+, TM4.A
unnamed: C31.-, R131.1, U24.3 (+IN)
unnamed: C202.1, R130.2, TM4.S, U24.2 (-IN)
unnamed: C31.+, Q35.E, R128.1
unnamed: C29.+, R124.1, R128.2
unnamed: C32.1, R132.1, R133.2
unnamed: C33.1, R132.2, U24.5 (+IN)
PN: C32.2, U24.6 (-IN), U24.7 (OUT); also elsewhere on the board
WN: C202.2, R130.1, R133.1, TP4.P$1, U24.1 (OUT); also elsewhere on the board

Notes on the sheet:
Noise
