e-licktronic/Yocto-V2.0/Eagle/Yocto v2.007.brd

## EAGLE design Eagle/Yocto v2.007.brd (continued)

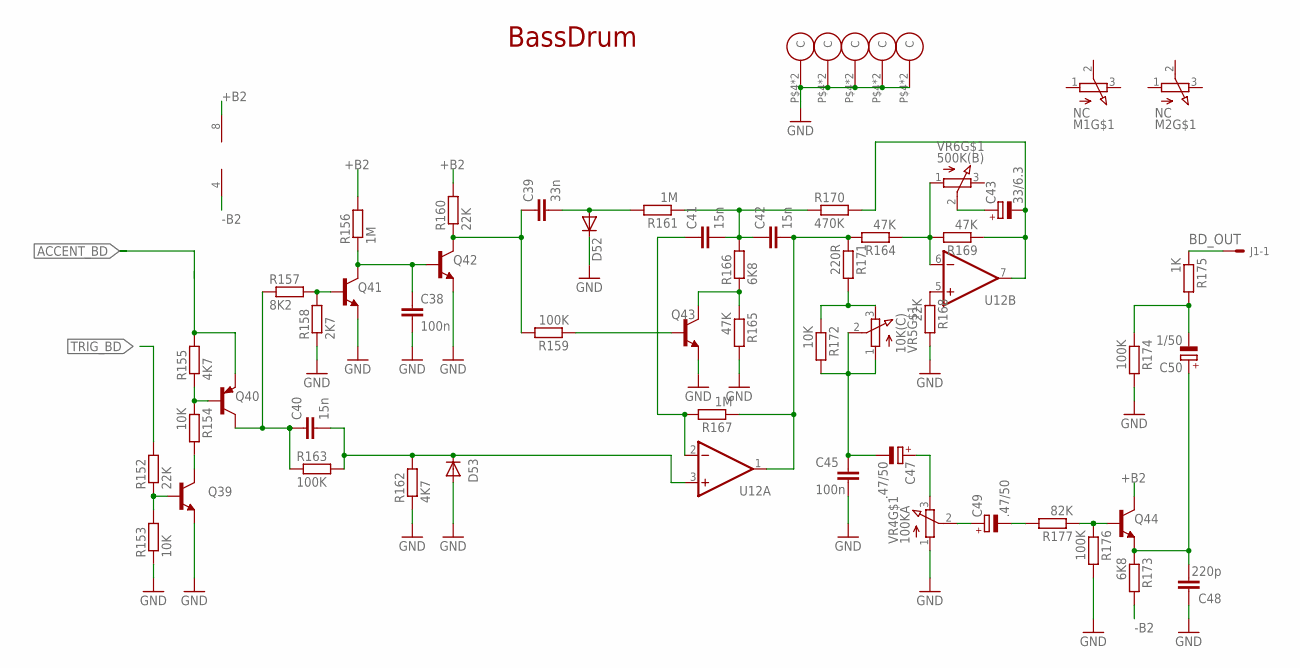
[picture p42: schematic Yocto v2.007.sch, sheet 7, BD]

Parts:
C38, C45: 100n; C050-025X075
C39: 33n; C050-025X075
C40, C41, C42: 15n; C050-025X075
C43: 33/6.3; E2,5-5
C47, C49: .47/50; E2,5-5
C48: 220p; C025-025X050
C50: 1/50; E2,5-5
D52, D53: 1N4148DO35-7; DO35-7
J1: 22-27-2041-04; 6410-04
M1, M2: NC; R0903N
Q39, Q41, Q42, Q43, Q44: 2SC945; TO-92-ECB-PERSO
Q40: 2SA733; TO-92-ECB-MARKED
R152: 22K; 0207/7
R153, R154: 10K; 0207/7
R155, R162: 4K7; 0207/5V
R156, R161, R167: 1M; 0207/5V
R157: 8K2; 0207/5V
R158: 2K7; 0207/5V
R159, R163, R174: 100K; 0207/5V
R160, R168: 22K; 0207/5V
R164: 47K; 0207/7
R165, R169: 47K; 0207/5V
R166, R173: 6K8; 0207/5V
R170: 470K; 0207/7
R171: 220R; 0207/5V
R172: 10K; 0207/5V
R175: 1K; 0207/5V
R176: 100K; 0207/7
R177: 82K; 0207/5V
U12: µPC4558CA; DIL08
VR4: 100KA; R0903N
VR5: 10K(C); R0903N
VR6: 500K(B); R0903N

Connections:
+B2: Q44.C, R156.2, R160.2, U12.8 (V+); also elsewhere on the board
-B2: R173.2, U12.4 (V-); also elsewhere on the board
ACCENT_BD: Q40.E, R155.2; also elsewhere on the board
BD_OUT: J1.1, R175.1
C1: C49.-, R177.2
GND: C38.2, C45.2, C48.1, D52.C, D53.A, M1.P$4 (C), M1.P$5 (C), M2.P$4 (C), M2.P$5 (C), Q39.E, Q41.E, Q42.E, Q43.E, R153.1, R158.1, R162.1, R165.2, R168.2, R174.2, R176.2, VR4.1 (A), VR4.P$4 (C), VR4.P$5 (C), VR5.P$4 (C), VR5.P$5 (C), VR6.P$4 (C), VR6.P$5 (C); also elsewhere on the board
unnamed: C38.1, Q41.C, Q42.B, R156.1
unnamed: Q40.B, R154.1, R155.1
unnamed: Q39.C, R154.2
unnamed: C39.1, Q42.C, R159.2, R160.1
unnamed: C40.1, Q40.C, R157.1, R163.1
unnamed: C40.2, D53.C, R162.2, R163.2, U12.3 (+IN)
unnamed: Q43.B, R159.1
unnamed: C41.2, C42.1, R161.1, R166.2, R170.1
unnamed: C41.1, R167.2, U12.2 (-IN)
unnamed: C42.2, R164.2, R167.1, R171.1, U12.1 (OUT)
unnamed: C45.1, C47.-, R172.2, VR5.1 (A), VR5.2 (S)
unnamed: R171.2, R172.1, VR5.3 (E)
unnamed: R164.1, R169.2, U12.6 (-IN), VR6.1 (A)
unnamed: C43.-, R169.1, R170.2, U12.7 (OUT)
unnamed: Q44.B, R176.1, R177.1
unnamed: C48.2, C50.+, Q44.E, R173.1
unnamed: C50.-, R174.1, R175.2
unnamed: C47.+, VR4.3 (E)
unnamed: C49.+, VR4.2 (S)
unnamed: C39.2, D52.A, R161.2
unnamed: C43.+, VR6.2 (S)
unnamed: R168.1, U12.5 (+IN)
unnamed: Q41.B, R157.2, R158.2
unnamed: Q43.C, R165.1, R166.1
unnamed: Q39.B, R152.1, R153.2
TRIG_BD: R152.2; also elsewhere on the board

Notes on the sheet:
BassDrum

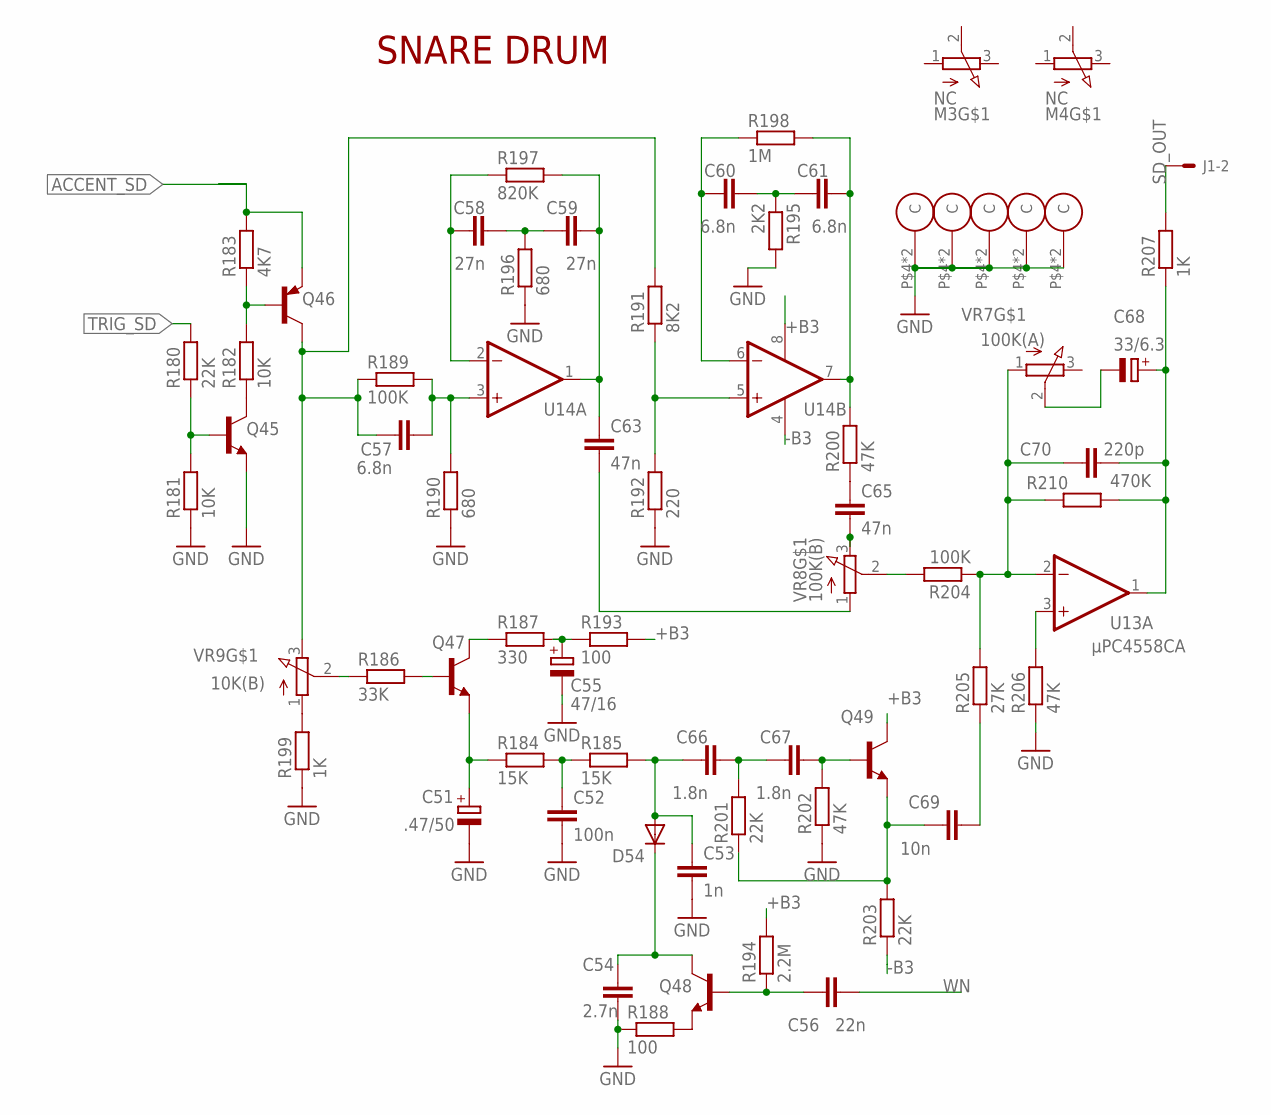
[picture p43: schematic Yocto v2.007.sch, sheet 8, SD]

Parts:
C51: .47/50; E2-5
C52: 100n; C050-025X075
C53: 1n; C050-025X075
C54: 2.7n; C050-025X075
C55: 47/16; E2-5
C56: 22n; C050-025X075
C57, C60, C61: 6.8n; C050-025X075
C58, C59: 27n; C050-025X075
C63, C65: 47n; C050-025X075
C66, C67: 1.8n; C050-025X075
C68: 33/6.3; E2-5
C69: 10n; C050-025X075
C70: 220p; C025-025X050
D54: 1N4148; DO35-7C
J1: 22-27-2041-04; 6410-04
M3, M4: NC; R0903N
Q45, Q47, Q48, Q49: 2SC945; TO-92-ECB-PERSO
Q46: 2SA733; TO-92-ECB-MARKED
R180, R201, R203: 22K; 0207/7
R181, R182: 10K; 0207/7
R183: 4K7; 0207/7
R184, R185: 15K; 0207/7
R186: 33K; 0207/7
R187: 330; 0207/7
R188, R193: 100; 0207/7
R189, R204: 100K; 0207/7
R190, R196: 680; 0207/7
R191: 8K2; 0207/7
R192: 220; 0207/7
R194: 2.2M; 0207/7
R195: 2K2; 0207/7
R197: 820K; 0207/7
R198: 1M; 0207/7
R199, R207: 1K; 0207/7
R200, R202, R206: 47K; 0207/7
R205: 27K; 0207/7
R210: 470K; 0207/7
U13, U14: µPC4558CA; DIL08
VR7: 100K(A); R0903N
VR8: 100K(B); R0903N
VR9: 10K(B); R0903N

Connections:
+B3: Q49.C, R193.2, R194.2, U14.8 (V+); also elsewhere on the board
-B3: R203.1, U14.4 (V-); also elsewhere on the board
ACCENT_SD: Q46.E, R183.2; also elsewhere on the board
GND: C51.-, C52.2, C53.2, C54.2, C55.-, M3.P$4 (C), M3.P$5 (C), M4.P$4 (C), M4.P$5 (C), Q45.E, R181.1, R188.1, R190.1, R192.1, R195.2, R196.1, R199.1, R202.1, R206.1, VR7.P$4 (C), VR7.P$5 (C), VR8.P$4 (C), VR8.P$5 (C), VR9.P$4 (C), VR9.P$5 (C); also elsewhere on the board
unnamed: Q45.B, R180.1, R181.2
unnamed: Q46.B, R182.2, R183.1
unnamed: Q45.C, R182.1
unnamed: C57.2, R189.2, R190.2, U14.3 (+IN)
unnamed: C57.1, Q46.C, R189.1, R191.2, VR9.3 (E)
unnamed: C58.1, R197.1, U14.2 (-IN)
unnamed: C59.2, C63.1, R197.2, U14.1 (OUT)
unnamed: C58.2, C59.1, R196.2
unnamed: C61.2, R198.2, R200.2, U14.7 (OUT)
unnamed: C60.2, C61.1, R195.1
unnamed: R191.1, R192.2, U14.5 (+IN)
unnamed: C63.2, VR8.1 (A)
unnamed: C65.1, R200.1
unnamed: R199.2, VR9.1 (A)
unnamed: C52.1, R184.2, R185.1
unnamed: R186.1, VR9.2 (S)
unnamed: Q47.B, R186.2
unnamed: Q47.C, R187.1
unnamed: C55.+, R187.2, R193.1
unnamed: C51.+, Q47.E, R184.1
unnamed: C53.1, C66.1, D54.A, R185.2
unnamed: C66.2, C67.1, R201.2
unnamed: C67.2, Q49.B, R202.2
unnamed: C69.1, Q49.E, R201.1, R203.2
unnamed: Q48.E, R188.2
unnamed: C54.1, D54.C, Q48.C
unnamed: C56.1, Q48.B, R194.1
unnamed: R204.2, VR8.2 (S)
unnamed: C70.1, R204.1, R205.2, R210.1, U13.2 (-IN), VR7.1 (A)
unnamed: C69.2, R205.1
unnamed: R206.2, U13.3 (+IN)
unnamed: C65.2, VR8.3 (E)
unnamed: C68.+, C70.2, R207.1, R210.2, U13.1 (OUT)
unnamed: C68.-, VR7.2 (S)
unnamed: C60.1, R198.1, U14.6 (-IN)
SD_OUT: J1.2, R207.2
TRIG_SD: R180.2; also elsewhere on the board
WN: C56.2; also elsewhere on the board

Notes on the sheet:
SNARE DRUM

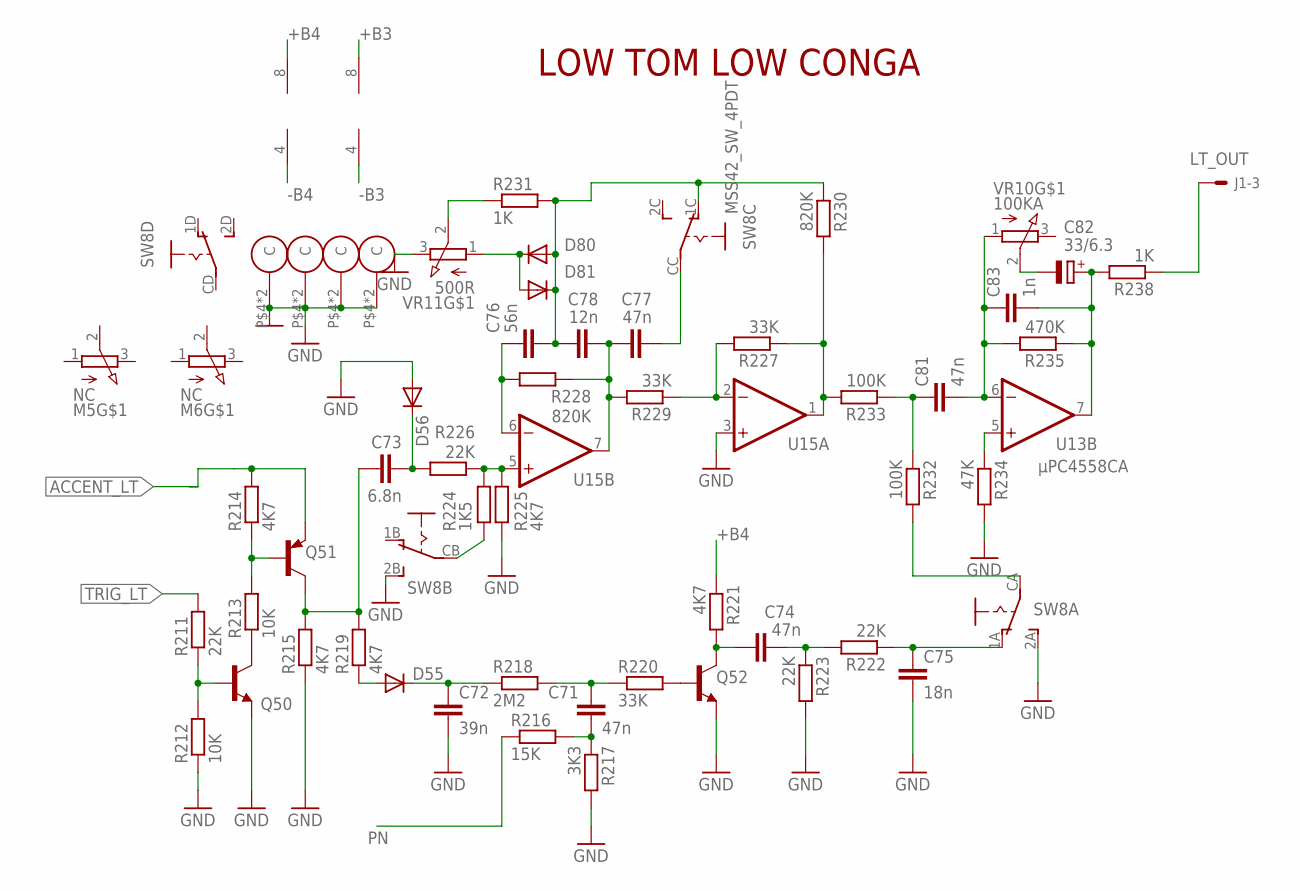
[picture p44: schematic Yocto v2.007.sch, sheet 9, LT]

Parts:
C71, C74, C77, C81: 47n; C050-025X075
C72: 39n; C050-025X075
C73: 6.8n; C050-025X075
C75: 18n; C050-025X075
C76: 56n; C050-025X075
C78: 12n; C050-025X075
C82: 33/6.3; E2-5
C83: 1n; C050-025X075
D55, D56: 1N4148; DO35-7C
D80, D81: 1N34; DO35-7C
J1: 22-27-2041-04; 6410-04
M5, M6: NC; R0903N
Q50, Q52: 2SC945; TO-92-ECB-PERSO
Q51: 2SA733; TO-92-ECB-MARKED
R211, R222, R223, R226: 22K; 0207/7
R212, R213: 10K; 0207/7
R214, R215, R219, R221, R225: 4K7; 0207/7
R216: 15K; 0207/7
R217: 3K3; 0207/7
R218: 2M2; 0207/7
R220, R227, R229: 33K; 0207/7
R224: 1K5; 0207/7
R228, R230: 820K; 0207/7
R231, R238: 1K; 0207/7
R232, R233: 100K; 0207/7
R234: 47K; 0207/7
R235: 470K; 0207/7
SW8: MSS42_SW_4PDT; MSS42_SW_SLIDE
U13, U15: µPC4558CA; DIL08
VR10: 100KA; R0903N
VR11: 500R; R0903N

Connections:
+B3: U13.8 (V+); also elsewhere on the board
+B4: R221.1, U15.8 (V+); also elsewhere on the board
-B3: U13.4 (V-); also elsewhere on the board
-B4: U15.4 (V-); also elsewhere on the board
ACCENT_LT: Q51.E, R214.2; also elsewhere on the board
GND: C72.2, C75.2, D56.A, M5.P$4 (C), M5.P$5 (C), M6.P$4 (C), M6.P$5 (C), Q50.E, Q52.E, R212.1, R215.1, R217.2, R223.2, R225.1, R234.2, SW8.2A (S), SW8.2B (S), SW8.P$1 (GND), SW8.P$2 (GND), SW8.P$3 (GND), SW8.P$4 (GND), U15.3 (+IN), VR10.P$4 (C), VR10.P$5 (C), VR11.3 (E), VR11.P$4 (C), VR11.P$5 (C); also elsewhere on the board
LT_OUT: J1.3, R238.1
unnamed: Q51.B, R213.2, R214.1
unnamed: Q50.C, R213.1
unnamed: Q50.B, R211.1, R212.2
unnamed: C73.1, Q51.C, R215.2, R219.2
unnamed: D55.A, R219.1
unnamed: C73.2, D56.C, R226.2
unnamed: C76.2, C78.1, D80.A, D81.C, R230.1, R231.2, SW8.1C (O)
unnamed: C76.1, R228.2, U15.6 (-IN)
unnamed: C77.1, C78.2, R228.1, R229.2, U15.7 (OUT)
unnamed: D80.C, D81.A, VR11.1 (A)
unnamed: R231.1, VR11.2 (S)
unnamed: R227.2, R229.1, U15.2 (-IN)
unnamed: R227.1, R230.2, R233.2, U15.1 (OUT)
unnamed: C81.1, R232.1, R233.1
unnamed: C81.2, C83.1, R235.2, U13.6 (-IN), VR10.1 (A)
unnamed: C82.-, VR10.2 (S)
unnamed: C82.+, C83.2, R235.1, R238.2, U13.7 (OUT)
unnamed: C74.1, Q52.C, R221.2
unnamed: C75.1, R222.1, SW8.1A (O)
unnamed: Q52.B, R220.2
unnamed: C71.2, R216.2, R217.1
unnamed: C72.1, D55.C, R218.1
unnamed: C77.2, SW8.CC
unnamed: R232.2, SW8.CA
unnamed: C74.2, R222.2, R223.1
unnamed: R224.2, R225.2, R226.1, U15.5 (+IN)
unnamed: R234.1, U13.5 (+IN)
unnamed: R224.1, SW8.CB
unnamed: C71.1, R218.2, R220.1
PN: R216.1; also elsewhere on the board
TRIG_LT: R211.2; also elsewhere on the board

Notes on the sheet:
LOW TOM LOW CONGA

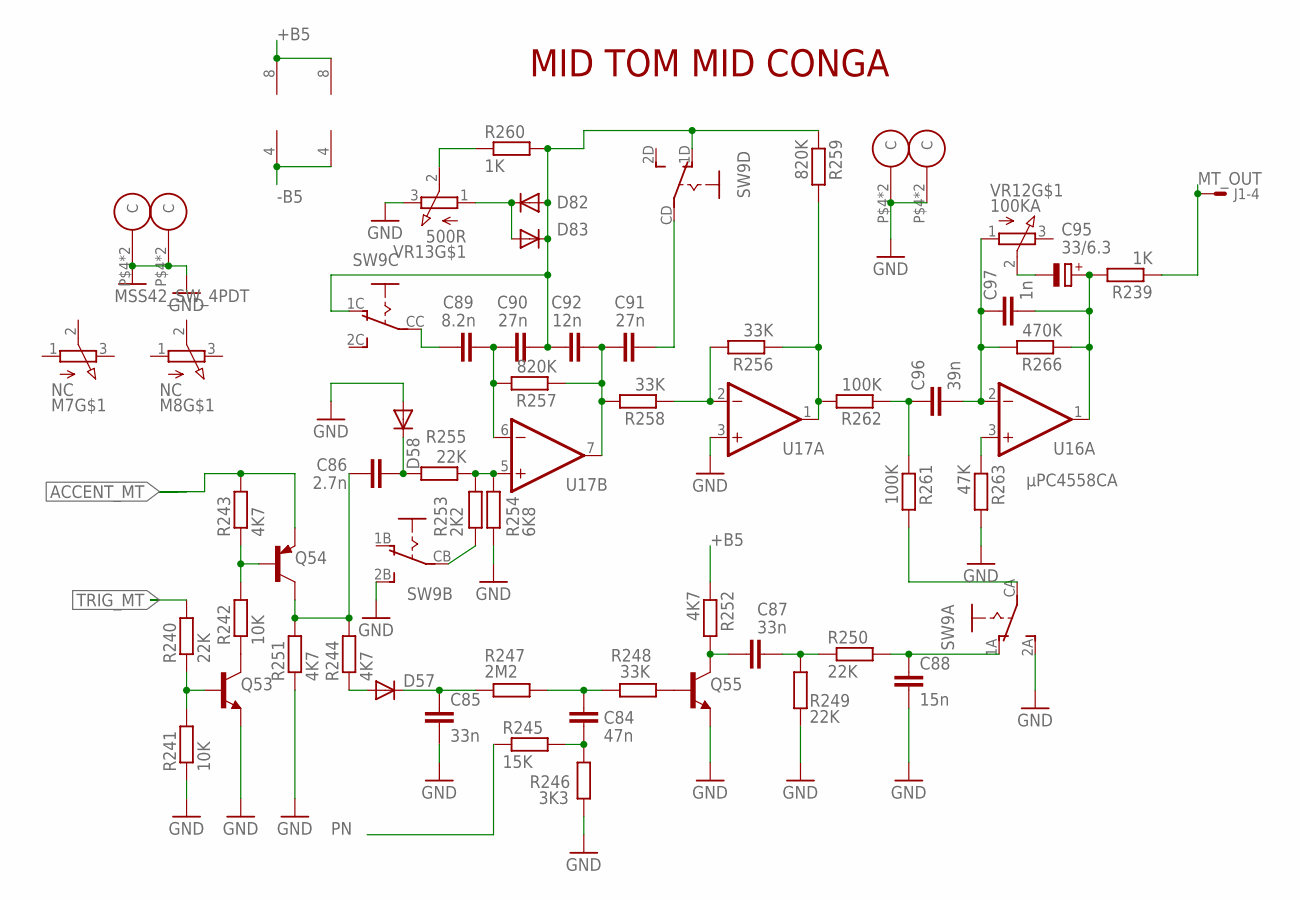
[picture p45: schematic Yocto v2.007.sch, sheet 10, MT]

Parts:
C84: 47n; C050-025X075
C85, C87: 33n; C050-025X075
C86: 2.7n; C050-025X075
C88: 15n; C050-025X075
C89: 8.2n; C050-025X075
C90, C91: 27n; C050-025X075
C92: 12n; C050-025X075
C95: 33/6.3; E2-5
C96: 39n; C050-025X075
C97: 1n; C050-025X075
D57, D58: 1N4148; DO35-7C
D82, D83: 1N34; DO35-7C
J1: 22-27-2041-04; 6410-04
M7, M8: NC; R0903N
Q53, Q55: 2SC945; TO-92-ECB-PERSO
Q54: 2SA733; TO-92-ECB-MARKED
R239, R260: 1K; 0207/7
R240, R249, R250, R255: 22K; 0207/7
R241, R242: 10K; 0207/7
R243, R244, R251, R252: 4K7; 0207/7
R245: 15K; 0207/7
R246: 3K3; 0207/7
R247: 2M2; 0207/7
R248, R256, R258: 33K; 0207/7
R253: 2K2; 0207/7
R254: 6K8; 0207/7
R257, R259: 820K; 0207/7
R261, R262: 100K; 0207/7
R263: 47K; 0207/7
R266: 470K; 0207/7
SW9: MSS42_SW_4PDT; MSS42_SW_SLIDE
U16, U17: µPC4558CA; DIL08
VR12: 100KA; R0903N
VR13: 500R; R0903N

Connections:
+B5: R252.1, U16.8 (V+), U17.8 (V+); also elsewhere on the board
-B5: U16.4 (V-), U17.4 (V-); also elsewhere on the board
ACCENT_MT: Q54.E, R243.2; also elsewhere on the board
GND: C85.2, C88.2, D58.A, M7.P$4 (C), M7.P$5 (C), M8.P$4 (C), M8.P$5 (C), Q53.E, Q55.E, R241.1, R246.2, R249.2, R251.1, R254.1, R263.2, SW9.2A (S), SW9.2B (S), SW9.P$1 (GND), SW9.P$2 (GND), SW9.P$3 (GND), SW9.P$4 (GND), U17.3 (+IN), VR12.P$4 (C), VR12.P$5 (C), VR13.3 (E), VR13.P$4 (C), VR13.P$5 (C); also elsewhere on the board
MT_OUT: J1.4, R239.1
unnamed: Q54.B, R242.2, R243.1
unnamed: Q53.C, R242.1
unnamed: Q53.B, R240.1, R241.2
unnamed: C86.1, Q54.C, R244.2, R251.2
unnamed: D57.A, R244.1
unnamed: C86.2, D58.C, R255.2
unnamed: C90.2, C92.1, D82.A, D83.C, R259.1, R260.2, SW9.1C (O), SW9.1D (O)
unnamed: C89.2, C90.1, R257.2, U17.6 (-IN)
unnamed: C91.1, C92.2, R257.1, R258.2, U17.7 (OUT)
unnamed: D82.C, D83.A, VR13.1 (A)
unnamed: R260.1, VR13.2 (S)
unnamed: R256.2, R258.1, U17.2 (-IN)
unnamed: R256.1, R259.2, R262.2, U17.1 (OUT)
unnamed: C96.1, R261.1, R262.1
unnamed: C96.2, C97.1, R266.2, U16.2 (-IN), VR12.1 (A)
unnamed: C95.-, VR12.2 (S)
unnamed: C95.+, C97.2, R239.2, R266.1, U16.1 (OUT)
unnamed: C87.1, Q55.C, R252.2
unnamed: C88.1, R250.2, SW9.1A (O)
unnamed: Q55.B, R248.2
unnamed: C84.2, R245.2, R246.1
unnamed: C84.1, R247.2, R248.1
unnamed: C85.1, D57.C, R247.1
unnamed: C91.2, SW9.CD
unnamed: R261.2, SW9.CA
unnamed: C87.2, R249.1, R250.1
unnamed: R263.1, U16.3 (+IN)
unnamed: R253.1, SW9.CB
unnamed: R253.2, R254.2, R255.1, U17.5 (+IN)
unnamed: C89.1, SW9.CC
PN: R245.1; also elsewhere on the board
TRIG_MT: R240.2; also elsewhere on the board

Notes on the sheet:
MID TOM MID CONGA

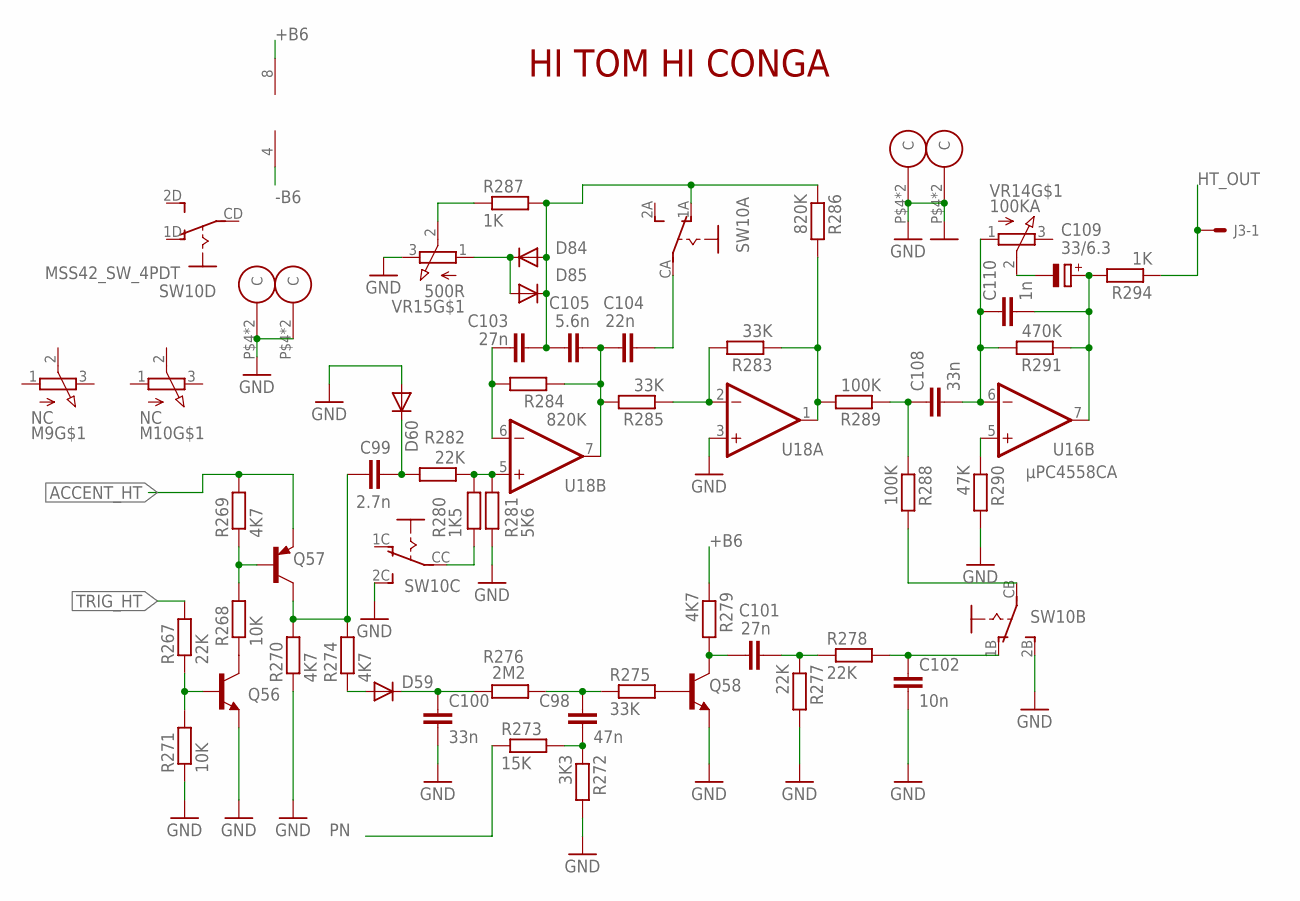
[picture p46: schematic Yocto v2.007.sch, sheet 11, HT]

Parts:
C98: 47n; C050-025X075
C99: 2.7n; C050-025X075
C100, C108: 33n; C050-025X075
C101, C103: 27n; C050-025X075
C102: 10n; C050-025X075
C104: 22n; C050-025X075
C105: 5.6n; C050-025X075
C109: 33/6.3; E2-5
C110: 1n; C050-025X075
D59, D60: 1N4148; DO35-7C
D84, D85: 1N34; DO35-7C
J3: 22-27-2041-04; 6410-04
M9, M10: NC; R0903N
Q56, Q58: 2SC945; TO-92-ECB-PERSO
Q57: 2SA733; TO-92-ECB-MARKED
R267, R277, R278, R282: 22K; 0207/7
R268, R271: 10K; 0207/7
R269, R270, R274, R279: 4K7; 0207/7
R272: 3K3; 0207/7
R273: 15K; 0207/7
R275, R283, R285: 33K; 0207/7
R276: 2M2; 0207/7
R280: 1K5; 0207/7
R281: 5K6; 0207/7
R284, R286: 820K; 0207/7
R287, R294: 1K; 0207/7
R288, R289: 100K; 0207/7
R290: 47K; 0207/7
R291: 470K; 0207/7
SW10: MSS42_SW_4PDT; MSS42_SW_SLIDE
U16, U18: µPC4558CA; DIL08
VR14: 100KA; R0903N
VR15: 500R; R0903N

Connections:
+B6: R279.1, U18.8 (V+); also elsewhere on the board
-B6: U18.4 (V-); also elsewhere on the board
ACCENT_HT: Q57.E, R269.2; also elsewhere on the board
GND: C100.2, C102.2, D60.A, M9.P$4 (C), M9.P$5 (C), M10.P$4 (C), M10.P$5 (C), Q56.E, Q58.E, R270.1, R271.1, R272.2, R277.2, R281.1, R290.2, SW10.2B (S), SW10.2C (S), SW10.P$1 (GND), SW10.P$2 (GND), SW10.P$3 (GND), SW10.P$4 (GND), U18.3 (+IN), VR14.P$4 (C), VR14.P$5 (C), VR15.3 (E), VR15.P$4 (C), VR15.P$5 (C); also elsewhere on the board
HT_OUT: J3.1, R294.1
unnamed: Q57.B, R268.2, R269.1
unnamed: Q56.C, R268.1
unnamed: Q56.B, R267.1, R271.2
unnamed: C99.1, Q57.C, R270.2, R274.2
unnamed: D59.A, R274.1
unnamed: C99.2, D60.C, R282.2
unnamed: C103.2, C105.1, D84.A, D85.C, R286.1, R287.2, SW10.1A (O)
unnamed: C103.1, R284.2, U18.6 (-IN)
unnamed: C104.1, C105.2, R284.1, R285.2, U18.7 (OUT)
unnamed: D84.C, D85.A, VR15.1 (A)
unnamed: R287.1, VR15.2 (S)
unnamed: R283.2, R285.1, U18.2 (-IN)
unnamed: R283.1, R286.2, R289.2, U18.1 (OUT)
unnamed: C108.1, R288.1, R289.1
unnamed: C108.2, C110.1, R291.2, U16.6 (-IN), VR14.1 (A)
unnamed: C109.-, VR14.2 (S)
unnamed: C109.+, C110.2, R291.1, R294.2, U16.7 (OUT)
unnamed: C101.1, Q58.C, R279.2
unnamed: C102.1, R278.2, SW10.1B (O)
unnamed: Q58.B, R275.2
unnamed: C98.2, R272.1, R273.2
unnamed: C98.1, R275.1, R276.2
unnamed: C100.1, D59.C, R276.1
unnamed: C104.2, SW10.CA
unnamed: R288.2, SW10.CB
unnamed: C101.2, R277.1, R278.1
unnamed: R290.1, U16.5 (+IN)
unnamed: R280.2, R281.2, R282.1, U18.5 (+IN)
unnamed: R280.1, SW10.CC
PN: R273.1; also elsewhere on the board
TRIG_HT: R267.2; also elsewhere on the board

Notes on the sheet:
HI TOM HI CONGA

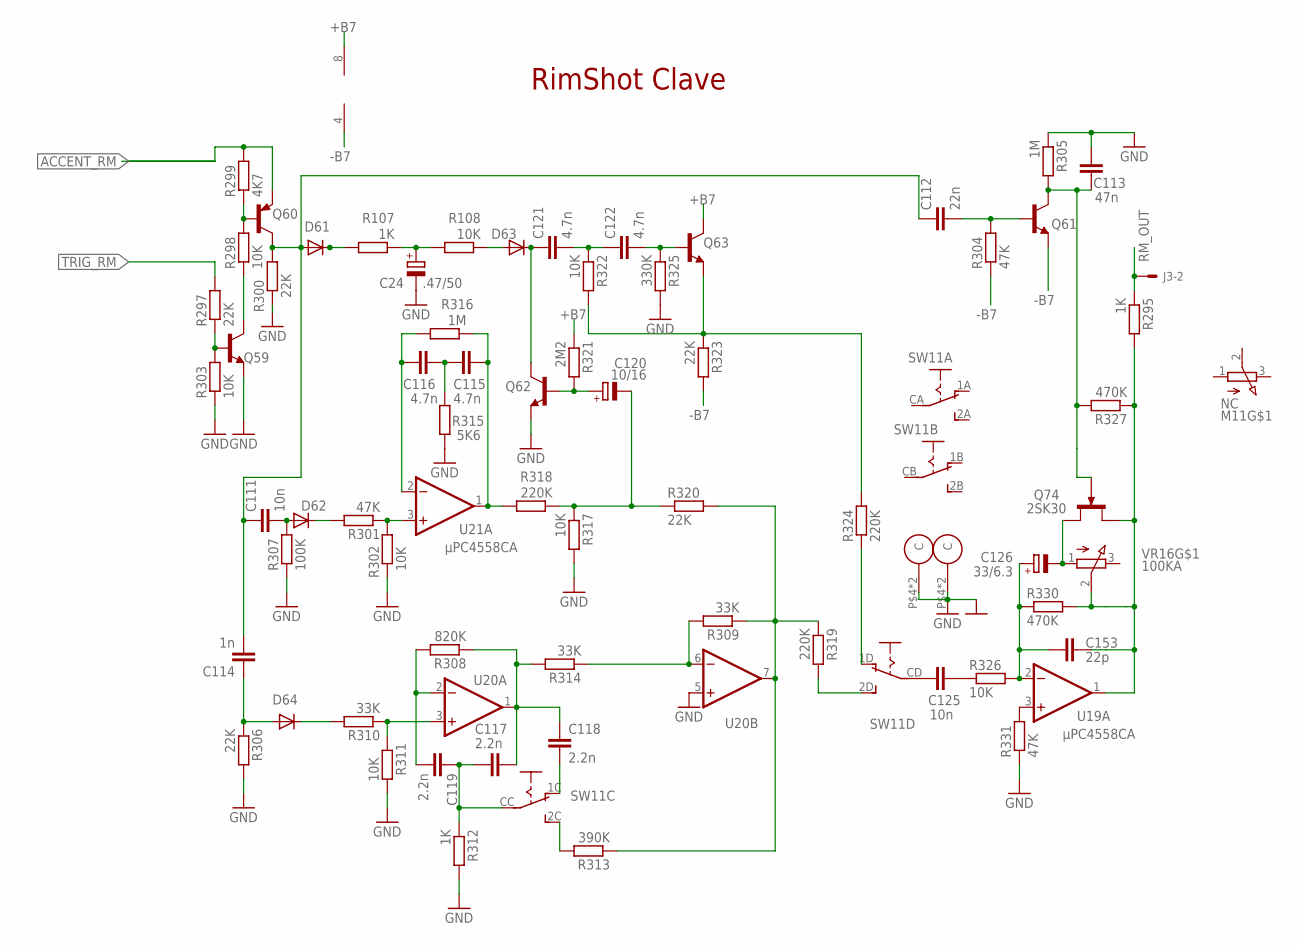
[picture p47: schematic Yocto v2.007.sch, sheet 12, RM]

Parts:
C24: .47/50; E2-5
C111, C125: 10n; C050-025X075
C112: 22n; C050-025X075
C113: 47n; C050-025X075
C114: 1n; C050-025X075
C115, C116, C121, C122: 4.7n; C050-025X075
C117, C118, C119: 2.2n; C050-025X075
C120: 10/16; E2-5
C126: 33/6.3; E2-5
C153: 22p; C025-025X050
D61, D62, D63, D64: 1N4148; DO35-7C
J3: 22-27-2041-04; 6410-04
M11: NC; R0903N
Q59, Q61, Q62, Q63: 2SC945; TO-92-ECB-PERSO
Q60: 2SA733; TO-92-ECB-MARKED
Q74: 2SK30; TO-92-MARKED_FET
R107, R295, R312: 1K; 0207/7
R108, R298, R302, R303, R311, R317, R322, R326: 10K; 0207/7
R297, R300, R306, R320, R323: 22K; 0207/7
R299: 4K7; 0207/7
R301, R304, R331: 47K; 0207/7
R305, R316: 1M; 0207/7
R307: 100K; 0207/7
R308: 820K; 0207/7
R309, R310, R314: 33K; 0207/7
R313: 390K; 0207/7
R315: 5K6; 0207/7
R318, R319, R324: 220K; 0207/7
R321: 2M2; 0207/7
R325: 330K; 0207/7
R327, R330: 470K; 0207/7
SW11: MSS42_SW_4PDT; MSS42_SW_SLIDE
U19, U20, U21: µPC4558CA; DIL08
VR16: 100KA; R0903N

Connections:
+B7: Q63.C, R321.1, U20.8 (V+); also elsewhere on the board
-B7: Q61.E, R304.1, R323.2, U20.4 (V-); also elsewhere on the board
ACCENT_RM: Q60.E, R299.2; also elsewhere on the board
GND: C24.-, C113.2, M11.P$4 (C), M11.P$5 (C), Q59.E, Q62.E, R300.1, R302.1, R303.1, R305.1, R306.2, R307.1, R311.2, R312.2, R315.1, R317.2, R325.2, R331.1, SW11.P$1 (GND), SW11.P$2 (GND), SW11.P$3 (GND), SW11.P$4 (GND), U20.5 (+IN), VR16.P$4 (C), VR16.P$5 (C); also elsewhere on the board
unnamed: C113.1, Q61.C, Q74.G, R305.2, R327.2
unnamed: C112.2, Q61.B, R304.2
unnamed: C118.2, SW11.1C (O)
unnamed: C24.+, R107.1, R108.2
unnamed: C153.2, Q74.D, R295.2, R327.1, R330.2, U19.1 (OUT), VR16.2 (S)
unnamed: C121.1, D63.C, Q62.C
unnamed: C114.1, D64.A, R306.1
unnamed: C120.+, Q62.B, R321.2
unnamed: C111.2, D62.A, R307.2
unnamed: R331.2, U19.3 (+IN)
unnamed: C125.1, SW11.CD
unnamed: R313.2, SW11.2C (S)
unnamed: Q60.B, R298.2, R299.1
unnamed: Q59.B, R297.1, R303.2
unnamed: Q59.C, R298.1
unnamed: D61.C, R107.2
unnamed: D63.A, R108.1
unnamed: C121.2, C122.1, R322.1
unnamed: C122.2, Q63.B, R325.1
unnamed: Q63.E, R322.2, R323.1, R324.2
unnamed: D62.C, R301.2
unnamed: R301.1, R302.2, U21.3 (+IN)
unnamed: D64.C, R310.2
unnamed: R310.1, R311.1, U20.3 (+IN)
unnamed: C117.2, C119.1, R312.1, SW11.CC
unnamed: C119.2, R308.2, U20.2 (-IN)
unnamed: C117.1, C118.1, R308.1, R314.2, U20.1 (OUT)
unnamed: R309.2, R314.1, U20.6 (-IN)
unnamed: R309.1, R313.1, R319.1, R320.2, U20.7 (OUT)
unnamed: R319.2, SW11.2D (S)
unnamed: C125.2, R326.1
unnamed: C126.+, C153.1, R326.2, R330.1, U19.2 (-IN)
unnamed: C126.-, Q74.S, VR16.1 (A)
unnamed: C115.2, C116.1, R315.2
unnamed: C116.2, R316.2, U21.2 (-IN)
unnamed: C115.1, R316.1, R318.2, U21.1 (OUT)
unnamed: C120.-, R317.1, R318.1, R320.1
unnamed: C111.1, C112.1, C114.2, D61.A, Q60.C, R300.2
unnamed: R324.1, SW11.1D (O)
RM_OUT: J3.2, R295.1
TRIG_RM: R297.2; also elsewhere on the board

Notes on the sheet:
RimShot Clave

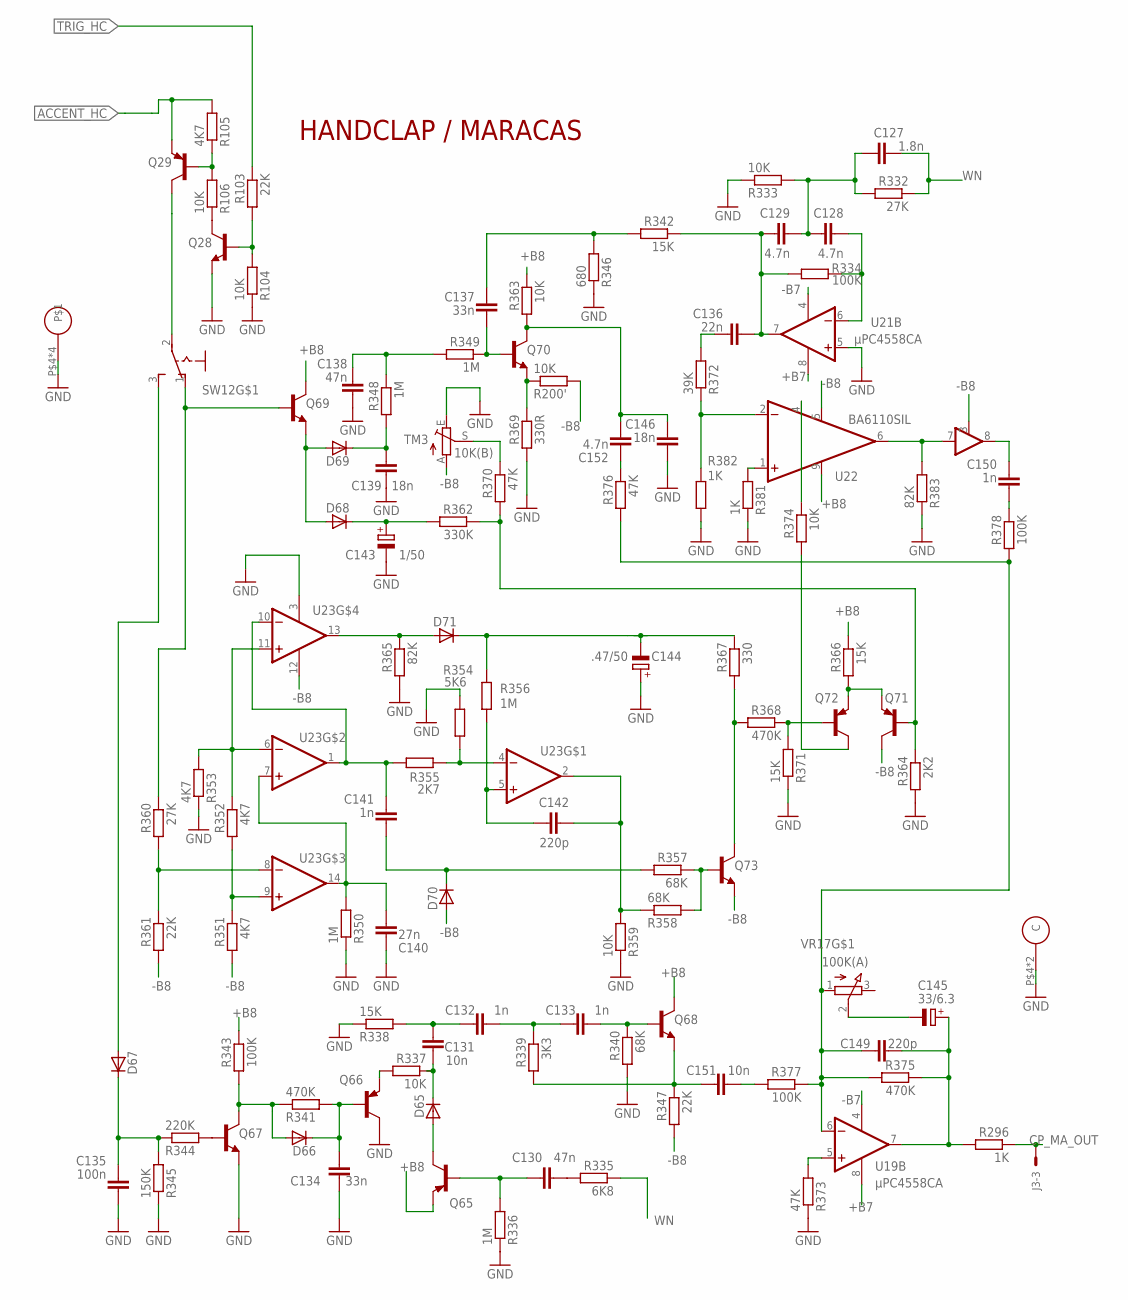
[picture p48: schematic Yocto v2.007.sch, sheet 13, HC]

Parts:
C127: 1.8n; C050-025X075
C128, C129, C152: 4.7n; C050-025X075
C130, C138: 47n; C050-025X075
C131, C151: 10n; C050-025X075
C132, C133, C141, C150: 1n; C050-025X075
C134, C137: 33n; C050-025X075
C135: 100n; C050-025X075
C136: 22n; C050-025X075
C139, C146: 18n; C050-025X075
C140: 27n; C050-025X075
C142, C149: 220p; C025-025X050
C143: 1/50; E2-5
C144: .47/50; E2-5
C145: 33/6.3; E2-5
D65, D66, D67, D68, D69, D70, D71: 1N4148; DO35-7C
J3: 22-27-2041-04; 6410-04
Q28, Q67, Q68, Q69, Q70, Q73: 2SC945; TO-92-ECB-PERSO
Q29, Q65, Q66, Q71, Q72: 2SA733; TO-92-ECB-MARKED
R103, R347, R361: 22K; 0207/7
R104, R106, R200', R333, R337, R359, R363, R374: 10K; 0207/7
R105, R351, R352, R353: 4K7; 0207/7
R296, R381, R382: 1K; 0207/7
R332, R360: 27K; 0207/7
R334, R343, R377, R378: 100K; 0207/7
R335: 6K8; 0207/7
R336, R348, R349, R350, R356: 1M; 0207/7
R338, R342, R366, R371: 15K; 0207/7
R339: 3K3; 0207/7
R340, R357, R358: 68K; 0207/7
R341, R368, R375: 470K; 0207/7
R344: 220K; 0207/7
R345: 150K; 0207/7
R346: 680; 0207/7
R354: 5K6; 0207/7
R355: 2K7; 0207/7
R362: 330K; 0207/7
R364: 2K2; 0207/7
R365, R383: 82K; 0207/7
R367: 330; 0207/7
R369: 330R; 0207/7
R370, R373, R376: 47K; 0207/7
R372: 39K; 0207/7
SW12: MSS12; MSS12_SW_SLIDE
TM3: 10K(B); CT6
U19, U21: µPC4558CA; DIL08
U22: BA6110SIL; SIL09
U23: AN6912; DIL14
VR17: 100K(A); R0903N

Connections:
+B7: U19.8 (V+), U21.8 (V+); also elsewhere on the board
+B8: Q65.E, Q68.C, Q69.C, R343.1, R363.1, R366.1, U22.9 (V+); also elsewhere on the board
-B7: U19.4 (V-), U21.4 (V-); also elsewhere on the board
-B8: D70.A, Q71.C, Q73.E, R200'.2, R347.2, R351.2, R361.2, TM3.A, U22.3, U22.5 (V-), U23.12 (V-); also elsewhere on the board
ACCENT_HC: Q29.E, R105.2; also elsewhere on the board
CPTRIG: Q29.C, SW12.2
CP_MA_OUT: J3.3, R296.1
GND: C134.2, C135.2, C138.2, C139.1, C140.1, C143.-, C144.+, C146.2, Q28.E, Q66.C, Q67.E, R104.1, R333.1, R336.1, R338.1, R340.2, R345.1, R346.1, R350.1, R353.1, R354.2, R359.1, R364.2, R365.2, R369.2, R371.1, R373.1, R381.1, R382.2, R383.1, SW12.P$4, SW12.P$5, SW12.P$6, SW12.P$7, TM3.E, U21.5 (+IN), U23.3 (V+), VR17.P$4 (C), VR17.P$5 (C); also elsewhere on the board
unnamed: Q28.B, R103.2, R104.2
unnamed: Q29.B, R105.1, R106.2
unnamed: Q28.C, R106.1
unnamed: C137.2, Q70.B, R349.1
unnamed: C139.2, D69.C, R348.2
unnamed: Q70.E, R200'.1, R369.1
unnamed: Q69.B, R360.1, SW12.1 (O)
unnamed: D68.A, D69.A, Q69.E
unnamed: C138.1, R348.1, R349.2
unnamed: C146.1, C152.1, Q70.C, R363.2
unnamed: C143.+, D68.C, R362.2
unnamed: Q71.B, R362.1, R364.1, R370.2
unnamed: R370.1, TM3.S
unnamed: C129.2, C136.1, R334.2, R342.1, U21.7 (OUT)
unnamed: C137.1, R342.2, R346.2
unnamed: C127.2, C128.2, C129.1, R332.2, R333.2
unnamed: C128.1, R334.1, U21.6 (-IN)
unnamed: C136.2, R372.2
unnamed: R372.1, R382.1, U22.2 (-IN)
unnamed: C152.2, R376.1
unnamed: C150.2, R378.1
unnamed: R383.2, U22.6 (OUT), U22.7 (IN1)
unnamed: C150.1, U22.8 (OUT1)
unnamed: R352.1, R353.2, U23.6 (-IN), U23.11 (+IN)
unnamed: D71.A, R365.1, U23.13 (OUT)
unnamed: C144.-, D71.C, R356.1, R367.1
unnamed: Q72.B, R368.1, R371.2
unnamed: Q71.E, Q72.E, R366.2
unnamed: Q72.C, R374.2
unnamed: Q73.C, R367.2, R368.2
unnamed: C142.2, R356.2, U23.5 (+IN)
unnamed: C141.1, R355.2, U23.1 (OUT), U23.10 (-IN)
unnamed: Q73.B, R357.1, R358.2
unnamed: C141.2, D70.C, R357.2
unnamed: C142.1, R358.1, R359.2, U23.2 (OUT)
unnamed: R351.1, R352.2, U23.9 (+IN)
unnamed: R360.2, R361.1, U23.8 (-IN)
unnamed: C140.2, R350.2, U23.7 (+IN), U23.14 (OUT)
unnamed: R354.1, R355.1, U23.4 (-IN)
unnamed: Q67.B, R344.2
unnamed: D65.A, Q65.C
unnamed: C135.1, D67.C, R344.1, R345.2
unnamed: C134.1, D66.C, Q66.B, R341.2
unnamed: Q66.E, R337.2
unnamed: C131.2, D65.C, R337.1
unnamed: C131.1, C132.2, R338.2
unnamed: C132.1, C133.2, R339.1
unnamed: C133.1, Q68.B, R340.1
unnamed: C151.2, Q68.E, R339.2, R347.1
unnamed: C130.2, Q65.B, R336.2
unnamed: C130.1, R335.2
unnamed: C151.1, R377.2
unnamed: R373.2, U19.5 (+IN)
unnamed: C149.2, R375.2, R376.2, R377.1, R378.2, U19.6 (-IN), VR17.1 (A)
unnamed: C145.+, C149.1, R296.2, R375.1, U19.7 (OUT)
unnamed: C145.-, VR17.2 (S)
unnamed: D67.A, SW12.3 (S)
unnamed: D66.A, Q67.C, R341.1, R343.2
unnamed: R381.2, U22.1 (+IN)
unnamed: R374.1, U22.4 (C)
TRIG_HC: R103.1; also elsewhere on the board
WN: C127.1, R332.1, R335.1; also elsewhere on the board

Notes on the sheet:
HANDCLAP / MARACAS

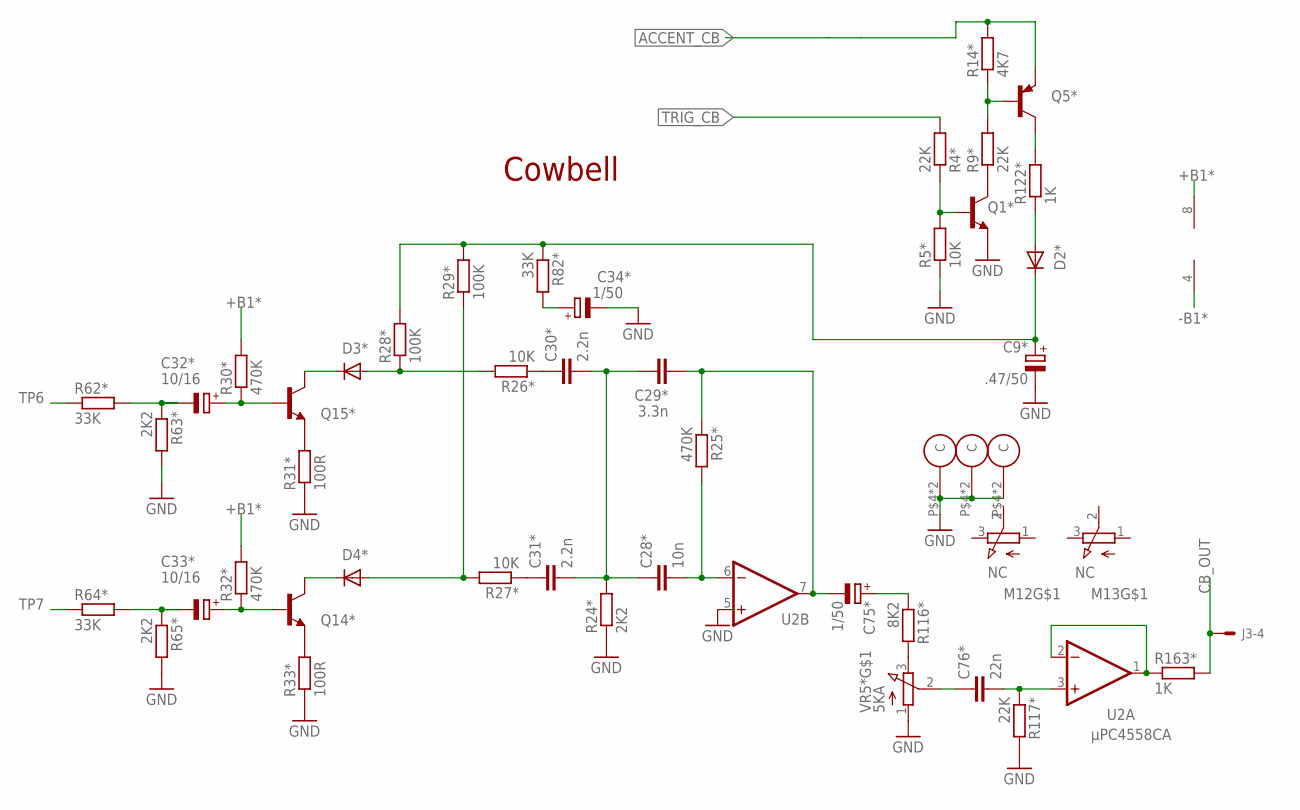
[picture p49: schematic Yocto v2.007.sch, sheet 14, CB]

Parts:
C9*: .47/50; E2-5
C28*: 10n; C050-025X075
C29*: 3.3n; C050-025X075
C30*, C31*: 2.2n; C050-025X075
C32*, C33*: 10/16; E2-5
C34*, C75*: 1/50; E2-5
C76*: 22n; C050-025X075
D2*, D3*, D4*: 1N4148; DO35-7C
J3: 22-27-2041-04; 6410-04
M12, M13: NC; R0903N
Q1*, Q14*, Q15*: 2SC945; TO-92-ECB-PERSO
Q5*: 2SA733; TO-92-ECB-MARKED
R4*, R9*, R117*: 22K; 0207/7
R5*, R26*, R27*: 10K; 0207/7
R14*: 4K7; 0207/7
R24*, R63*, R65*: 2K2; 0207/7
R25*, R30*, R32*: 470K; 0207/7
R28*, R29*: 100K; 0207/7
R31*, R33*: 100R; 0207/7
R62*, R64*, R82*: 33K; 0207/7
R116*: 8K2; 0207/7
R122*, R163*: 1K; 0207/7
U2: µPC4558CA; DIL08
VR5*: 5KA; R0903N

Connections:
+B1*: R30*.2, R32*.2, U2.8 (V+); also elsewhere on the board
-B1*: U2.4 (V-); also elsewhere on the board
ACCENT_CB: Q5*.E, R14*.2; also elsewhere on the board
CB_OUT: J3.4, R163*.2
GND: C9*.-, C34*.-, M12.P$4 (C), M12.P$5 (C), M13.P$4 (C), M13.P$5 (C), Q1*.E, R5*.1, R24*.1, R31*.1, R33*.1, R63*.2, R65*.2, R117*.2, U2.5 (+IN), VR5*.1 (A), VR5*.P$4 (C), VR5*.P$5 (C); also elsewhere on the board
unnamed: Q5*.B, R9*.2, R14*.1
unnamed: Q1*.C, R9*.1
unnamed: Q1*.B, R4*.1, R5*.2
unnamed: C9*.+, D2*.C, R28*.2, R29*.2, R82*.1
unnamed: Q15*.E, R31*.2
unnamed: C32*.+, Q15*.B, R30*.1
unnamed: D3*.C, Q15*.C
unnamed: D3*.A, R26*.2, R28*.1
unnamed: Q14*.E, R33*.2
unnamed: C33*.+, Q14*.B, R32*.1
unnamed: D4*.C, Q14*.C
unnamed: D4*.A, R27*.2, R29*.1
unnamed: C30*.1, R26*.1
unnamed: C31*.1, R27*.1
unnamed: C28*.1, C29*.1, C30*.2, C31*.2, R24*.2
unnamed: C29*.2, C75*.-, R25*.1, U2.7 (OUT)
unnamed: C28*.2, R25*.2, U2.6 (-IN)
unnamed: R163*.1, U2.1 (OUT), U2.2 (-IN)
unnamed: C76*.2, R117*.1, U2.3 (+IN)
unnamed: C76*.1, VR5*.2 (S)
unnamed: R116*.2, VR5*.3 (E)
unnamed: C75*.+, R116*.1
unnamed: C32*.-, R62*.2, R63*.1
unnamed: C33*.-, R64*.2, R65*.1
unnamed: C34*.+, R82*.2
unnamed: Q5*.C, R122*.2
unnamed: D2*.A, R122*.1
TP6: R62*.1; also elsewhere on the board
TP7: R64*.1; also elsewhere on the board
TRIG_CB: R4*.2; also elsewhere on the board

Notes on the sheet:
Cowbell
