e-licktronic/Yocto-V2.0/Eagle/Yocto v2.007.brd

## EAGLE design Eagle/Yocto v2.007.brd (continued)

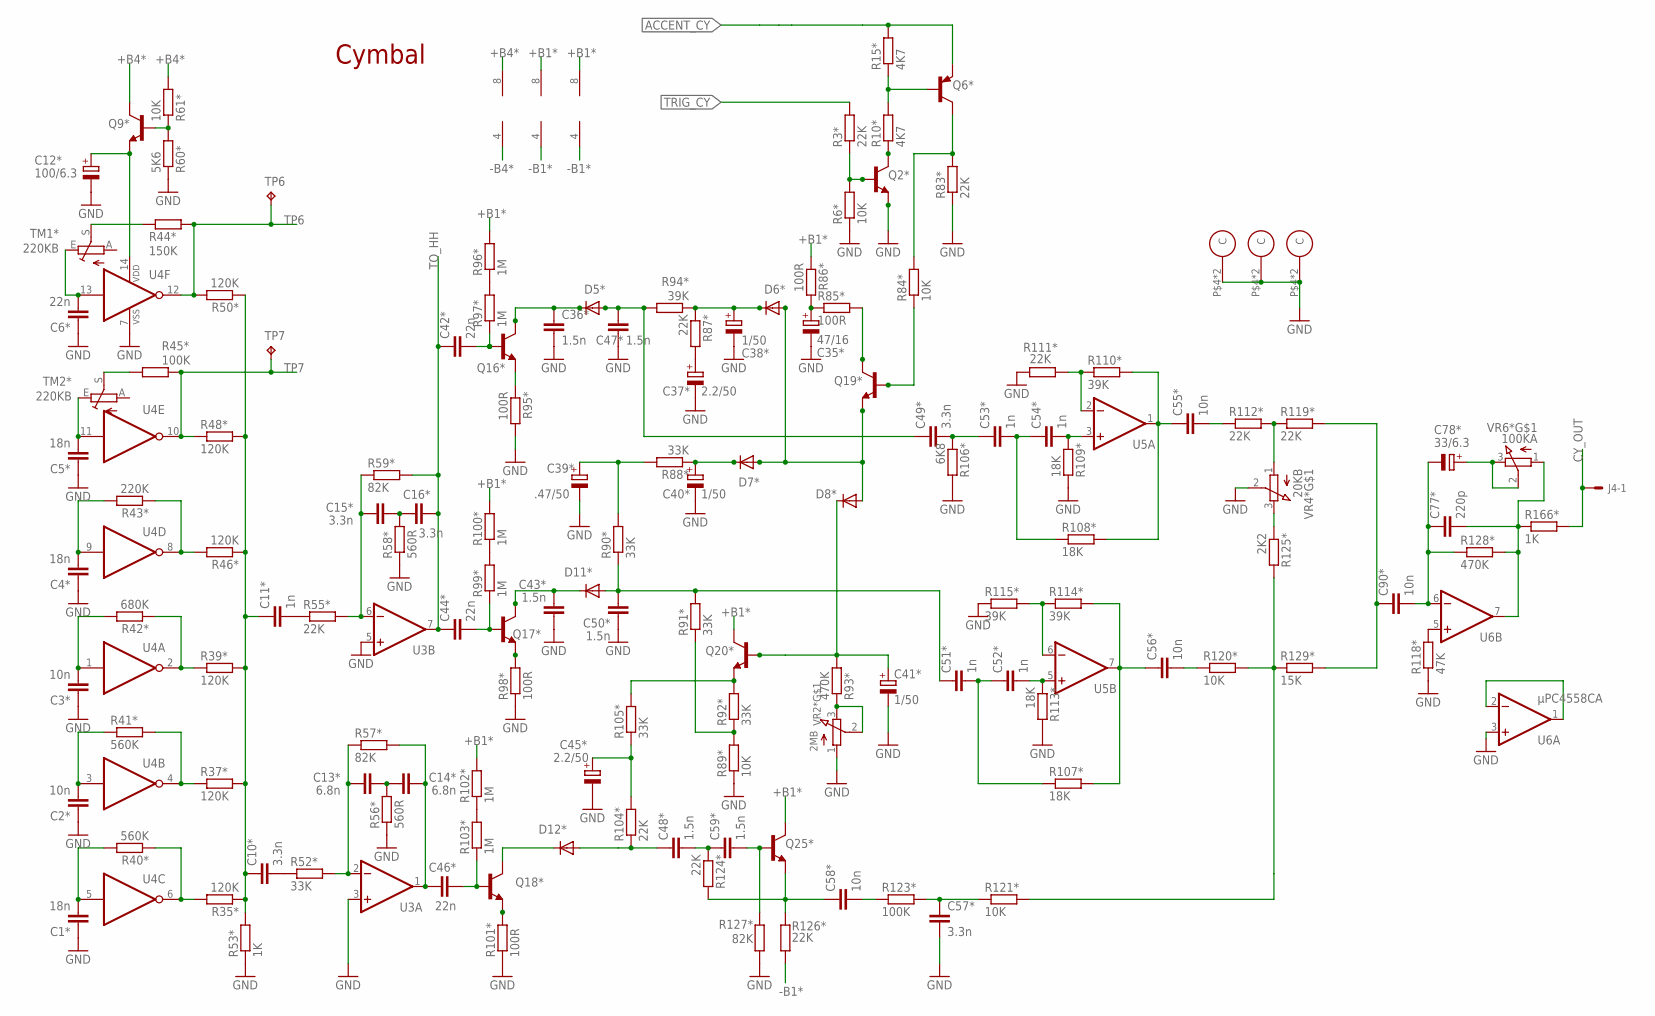
[picture p50: schematic Yocto v2.007.sch, sheet 15, CY]

Parts:
C1*, C4*, C5*: 18n; C050-025X075
C2*, C3*, C55*, C56*, C58*, C90*: 10n; C050-025X075
C6*, C42*, C44*, C46*: 22n; C050-025X075
C10*, C15*, C16*, C49*, C57*: 3.3n; C050-025X075
C11*, C51*, C52*, C53*, C54*: 1n; C050-025X075
C12*: 100/6.3; E2-5
C13*, C14*: 6.8n; C050-025X075
C35*: 47/16; E2-5
C36*, C43*, C47*, C48*, C50*, C59*: 1.5n; C050-025X075
C37*, C45*: 2.2/50; E2-5
C38*, C40*, C41*: 1/50; E2-5
C39*: .47/50; E2-5
C77*: 220p; C025-025X050
C78*: 33/6.3; E2-5
D5*, D6*, D7*, D8*, D11*, D12*: 1N4148; DO35-7C
J4: 22-27-2041-04; 6410-04
Q2*, Q9*, Q16*, Q17*, Q18*, Q19*, Q20*, Q25*: 2SC945; TO-92-ECB-PERSO
Q6*: 2SA733; TO-92-ECB-MARKED
R3*, R55*, R83*, R87*, R104*, R111*, R112*, R119*, R124*, R126*: 22K; 0207/7
R6*, R61*, R84*, R89*, R120*, R121*: 10K; 0207/7
R10*, R15*: 4K7; 0207/7
R35*, R37*, R39*, R46*, R48*, R50*: 120K; 0207/7
R40*, R41*: 560K; 0207/7
R42*: 680K; 0207/7
R43*: 220K; 0207/7
R44*: 150K; 0207/7
R45*, R123*: 100K; 0207/7
R52*, R88*, R90*, R91*, R92*, R105*: 33K; 0207/7
R53*, R166*: 1K; 0207/7
R56*, R58*: 560R; 0207/7
R57*, R59*, R127*: 82K; 0207/7
R60*: 5K6; 0207/7
R85*, R86*, R95*, R98*, R101*: 100R; 0207/7
R93*, R128*: 470K; 0207/7
R94*, R110*, R114*, R115*: 39K; 0207/7
R96*, R97*, R99*, R100*, R102*, R103*: 1M; 0207/7
R106*: 6K8; 0207/7
R107*, R108*, R109*, R113*: 18K; 0207/7
R118*: 47K; 0207/7
R125*: 2K2; 0207/7
R129*: 15K; 0207/7
TM1*, TM2*: 220KB; CT6
TP6, TP7: TPB0,8; B0,8
U3, U5, U6: µPC4558CA; DIL08
U4: 4584N; DIL14
VR2*: 2MB; R1212N
VR4*: 20KB; R0903N
VR6*: 100KA; R0903N

Connections:
+B1*: Q20*.C, Q25*.C, R86*.1, R96*.2, R100*.2, R102*.2, U5.8 (V+), U6.8 (V+); also elsewhere on the board
+B4*: Q9*.C, R61*.2, U3.8 (V+); also elsewhere on the board
-B1*: R126*.2, U5.4 (V-), U6.4 (V-); also elsewhere on the board
-B4*: U3.4 (V-); also elsewhere on the board
ACCENT_CY: Q6*.E, R15*.2; also elsewhere on the board
CY_OUT: J4.1, R166*.2
GND: C1*.1, C2*.1, C3*.1, C4*.1, C5*.1, C6*.1, C12*.-, C35*.-, C36*.2, C37*.-, C38*.-, C39*.-, C40*.-, C41*.-, C43*.1, C45*.-, C47*.2, C50*.1, C57*.2, Q2*.E, R6*.1, R53*.1, R56*.1, R58*.1, R60*.1, R83*.1, R89*.1, R95*.2, R98*.1, R101*.1, R106*.2, R109*.2, R111*.1, R113*.2, R115*.1, R118*.1, R127*.2, U3.3 (+IN), U3.5 (+IN), U4.7 (VSS), U6.3 (+IN), VR2*.1 (A), VR2*.P$4 (C), VR2*.P$5 (C), VR4*.2 (S), VR4*.P$4 (C), VR4*.P$5 (C), VR6*.P$4 (C), VR6*.P$5 (C); also elsewhere on the board
unnamed: C78*.+, VR6*.2 (S), VR6*.3 (E)
unnamed: R102*.1, R103*.2
unnamed: C58*.1, Q25*.E, R124*.2, R126*.1
unnamed: R93*.1, VR2*.2 (S), VR2*.3 (E)
unnamed: R99*.2, R100*.1
unnamed: R96*.1, R97*.2
unnamed: R118*.2, U6.5 (+IN)
unnamed: C1*.2, R40*.2, U4.5 (I)
unnamed: C2*.2, R41*.1, U4.3 (I)
unnamed: C3*.2, R42*.2, U4.1 (I)
unnamed: C4*.2, R43*.2, U4.9 (I)
unnamed: C5*.2, TM2*.E, U4.11 (I)
unnamed: C6*.2, TM1*.E, U4.13 (I)
unnamed: R35*.2, R40*.1, U4.6 (O)
unnamed: R37*.1, R41*.2, U4.4 (O)
unnamed: R43*.1, R46*.2, U4.8 (O)
unnamed: R45*.1, TM2*.S
unnamed: R44*.1, TM1*.S
unnamed: C12*.+, Q9*.E, U4.14 (VDD)
unnamed: Q9*.B, R60*.2, R61*.1
unnamed: R39*.1, R42*.1, U4.2 (O)
unnamed: C50*.2, C51*.1, D11*.A, R90*.1, R91*.2
unnamed: Q16*.E, R95*.1
unnamed: U6.1 (OUT), U6.2 (-IN)
unnamed: C10*.1, C11*.1, R35*.1, R37*.2, R39*.2, R46*.1, R48*.2, R50*.1, R53*.2
unnamed: C11*.2, R55*.1
unnamed: C15*.1, R55*.2, R59*.1, U3.6 (-IN)
unnamed: C44*.2, Q17*.B, R99*.1
unnamed: Q17*.E, R98*.2
unnamed: C43*.2, D11*.C, Q17*.C
unnamed: C39*.+, R88*.2, R90*.2
unnamed: C10*.2, R52*.1
unnamed: C13*.1, R52*.2, R57*.1, U3.2 (-IN)
unnamed: C14*.2, C46*.1, R57*.2, U3.1 (OUT)
unnamed: C46*.2, Q18*.B, R103*.1
unnamed: Q18*.E, R101*.2
unnamed: D12*.C, Q18*.C
unnamed: C48*.1, D12*.A, R104*.1
unnamed: C40*.+, D7*.C, R88*.1
unnamed: C35*.+, R85*.1, R86*.2
unnamed: Q19*.C, R85*.2
unnamed: D6*.A, D7*.A, D8*.A, Q19*.E
unnamed: Q19*.B, R84*.1
unnamed: Q6*.C, R83*.2, R84*.2
unnamed: Q6*.B, R10*.2, R15*.1
unnamed: Q2*.B, R3*.1, R6*.2
unnamed: Q2*.C, R10*.1
unnamed: C36*.1, D5*.C, Q16*.C
unnamed: C47*.1, C49*.1, D5*.A, R94*.2
unnamed: C42*.2, Q16*.B, R97*.1
unnamed: C37*.+, R87*.2
unnamed: Q20*.E, R92*.2, R105*.2
unnamed: R89*.2, R91*.1, R92*.1
unnamed: C41*.+, D8*.C, Q20*.B, R93*.2
unnamed: C49*.2, C53*.1, R106*.1
unnamed: C54*.2, R109*.1, U5.3 (+IN)
unnamed: R112*.2, R119*.1, VR4*.1 (A)
unnamed: C55*.1, R108*.2, R110*.2, U5.1 (OUT)
unnamed: C53*.2, C54*.1, R108*.1
unnamed: R110*.1, R111*.2, U5.2 (-IN)
unnamed: C55*.2, R112*.1
unnamed: R125*.1, VR4*.3 (E)
unnamed: C52*.2, R113*.1, U5.5 (+IN)
unnamed: C56*.1, R107*.2, R114*.2, U5.7 (OUT)
unnamed: C51*.2, C52*.1, R107*.1
unnamed: R114*.1, R115*.2, U5.6 (-IN)
unnamed: C77*.1, C78*.-, C90*.2, R128*.1, U6.6 (-IN)
unnamed: C77*.2, R128*.2, R166*.1, U6.7 (OUT), VR6*.1 (A)
unnamed: C56*.2, R120*.1
unnamed: R120*.2, R121*.2, R125*.2, R129*.1
unnamed: C90*.1, R119*.2, R129*.2
unnamed: C48*.2, C59*.1, R124*.1
unnamed: C59*.2, Q25*.B, R127*.1
unnamed: C58*.2, R123*.1
unnamed: C57*.1, R121*.1, R123*.2
unnamed: C15*.2, C16*.1, R58*.2
unnamed: C13*.2, C14*.1, R56*.2
unnamed: C45*.+, R104*.2, R105*.1
unnamed: C38*.+, D6*.C, R87*.1, R94*.1
TO_HH: C16*.2, C42*.1, C44*.1, R59*.2, U3.7 (OUT); also elsewhere on the board
TP6: R44*.2, R50*.2, TP6.P$1, U4.12 (O); also elsewhere on the board
TP7: R45*.2, R48*.1, TP7.P$1, U4.10 (O); also elsewhere on the board
TRIG_CY: R3*.2; also elsewhere on the board

Notes on the sheet:
Cymbal

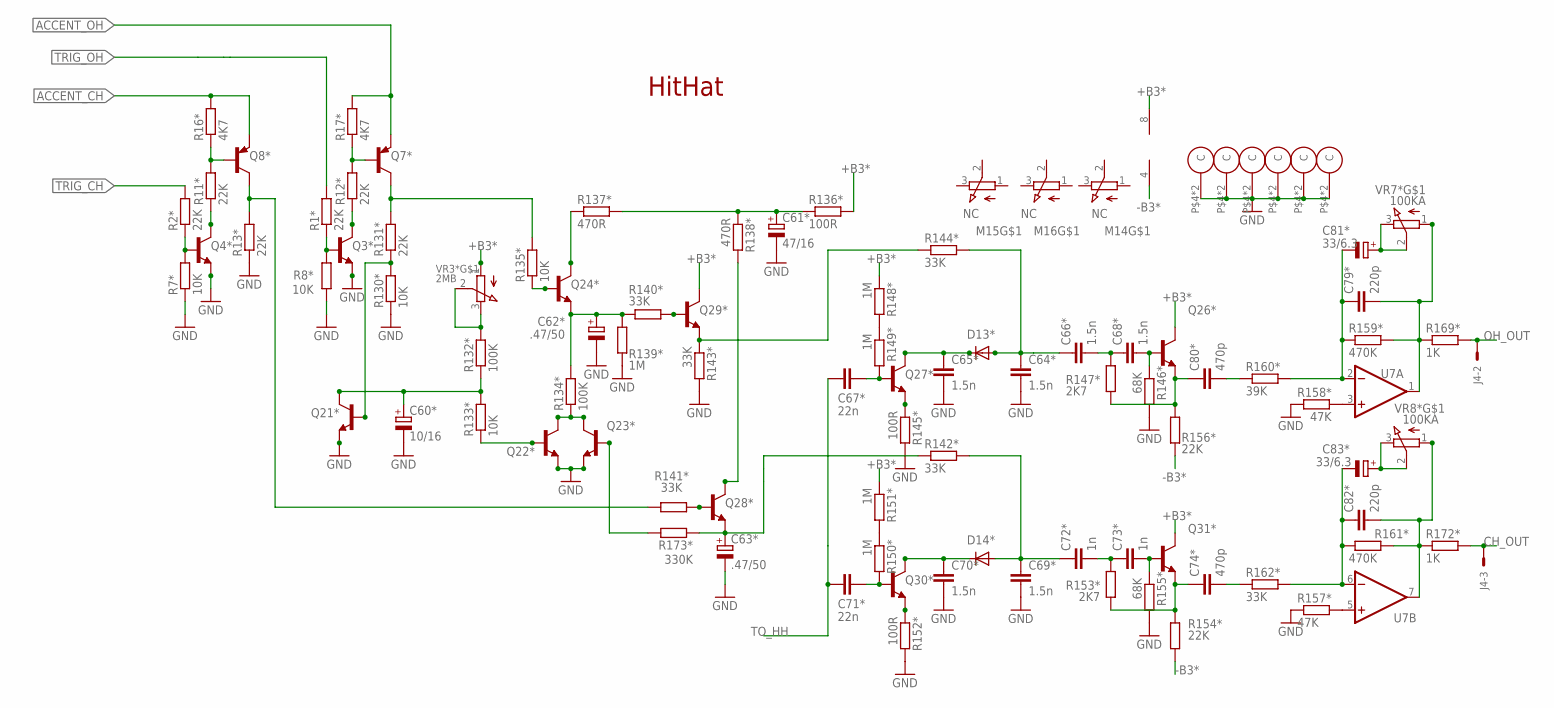
[picture p51: schematic Yocto v2.007.sch, sheet 16, HH]

Parts:
C60*: 10/16; E2-5
C61*: 47/16; E2-5
C62*, C63*: .47/50; E2-5
C64*, C65*, C66*, C68*, C69*, C70*: 1.5n; C050-025X075
C67*, C71*: 22n; C050-025X075
C72*, C73*: 1n; C050-025X075
C74*, C80*: 470p; C050-025X075
C79*, C82*: 220p; C025-025X050
C81*, C83*: 33/6.3; E2-5
D13*, D14*: 1N4148; DO35-7C
J4: 22-27-2041-04; 6410-04
M14, M15, M16: NC; R0903N
Q3*, Q4*, Q21*, Q22*, Q23*, Q24*, Q26*, Q27*, Q28*, Q29*, Q30*, Q31*: 2SC945; TO-92-ECB-PERSO
Q7*, Q8*: 2SA733; TO-92-ECB-MARKED
R1*, R2*, R11*, R12*, R13*, R131*, R154*, R156*: 22K; 0207/7
R7*, R8*, R130*, R133*, R135*: 10K; 0207/7
R16*, R17*: 4K7; 0207/7
R132*, R134*: 100K; 0207/7
R136*, R145*, R152*: 100R; 0207/7
R137*, R138*: 470R; 0207/7
R139*, R148*, R149*, R150*, R151*: 1M; 0207/7
R140*, R141*, R142*, R143*, R144*, R162*: 33K; 0207/7
R146*, R155*: 68K; 0207/7
R147*, R153*: 2K7; 0207/7
R157*, R158*: 47K; 0207/7
R159*, R161*: 470K; 0207/7
R160*: 39K; 0207/7
R169*, R172*: 1K; 0207/7
R173*: 330K; 0207/7
U7: µPC4558CA; DIL08
VR3*: 2MB; R1212N
VR7*, VR8*: 100KA; R0903N

Connections:
+B3*: Q26*.C, Q29*.C, Q31*.C, R136*.2, R148*.1, R151*.1, U7.8 (V+), VR3*.1 (A); also elsewhere on the board
-B3*: R154*.2, R156*.2, U7.4 (V-); also elsewhere on the board
ACCENT_CH: Q8*.E, R16*.2; also elsewhere on the board
ACCENT_OH: Q7*.E, R17*.2; also elsewhere on the board
CH_OUT: J4.3, R172*.2
GND: C60*.-, C61*.-, C62*.-, C63*.-, C64*.2, C65*.2, C69*.2, C70*.2, M14.P$4 (C), M14.P$5 (C), M15.P$4 (C), M15.P$5 (C), M16.P$4 (C), M16.P$5 (C), Q3*.E, Q4*.E, Q21*.E, Q22*.E, Q23*.E, R7*.1, R8*.1, R13*.1, R130*.1, R139*.2, R143*.2, R145*.2, R146*.2, R152*.2, R155*.2, R157*.1, R158*.1, VR3*.P$4 (C), VR3*.P$5 (C), VR7*.P$4 (C), VR7*.P$5 (C), VR8*.P$4 (C), VR8*.P$5 (C); also elsewhere on the board
unnamed: C70*.1, D14*.C, Q30*.C
unnamed: C73*.2, Q31*.B, R155*.1
unnamed: C74*.2, R162*.1
unnamed: C80*.2, R160*.1
unnamed: C79*.1, C81*.-, R159*.1, R160*.2, U7.2 (-IN)
unnamed: C79*.2, R159*.2, R169*.1, U7.1 (OUT), VR7*.1 (A)
unnamed: C82*.1, C83*.-, R161*.1, R162*.2, U7.6 (-IN)
unnamed: C82*.2, R161*.2, R172*.1, U7.7 (OUT), VR8*.1 (A)
unnamed: Q21*.B, R130*.2, R131*.1
unnamed: Q29*.B, R140*.2
unnamed: C80*.1, Q26*.E, R147*.2, R156*.1
unnamed: C74*.1, Q31*.E, R153*.2, R154*.1
unnamed: C81*.+, VR7*.2 (S), VR7*.3 (E)
unnamed: R148*.2, R149*.1
unnamed: C64*.1, C66*.1, D13*.A, R144*.2
unnamed: C69*.1, C72*.1, D14*.A, R142*.2
unnamed: R150*.1, R151*.2
unnamed: R158*.2, U7.3 (+IN)
unnamed: R157*.2, U7.5 (+IN)
unnamed: R132*.2, VR3*.2 (S), VR3*.3 (E)
unnamed: C83*.+, VR8*.2 (S), VR8*.3 (E)
unnamed: Q4*.B, R2*.1, R7*.2
unnamed: Q8*.B, R11*.2, R16*.1
unnamed: Q4*.C, R11*.1
unnamed: Q8*.C, R13*.2, R141*.1
unnamed: Q3*.B, R1*.1, R8*.2
unnamed: Q7*.B, R12*.2, R17*.1
unnamed: Q3*.C, R12*.1
unnamed: Q7*.C, R131*.2, R135*.2
unnamed: Q24*.C, R137*.1
unnamed: Q24*.B, R135*.1
unnamed: C62*.+, Q24*.E, R134*.2, R139*.1, R140*.1
unnamed: Q22*.C, Q23*.C, R134*.1
unnamed: Q22*.B, R133*.1
unnamed: C60*.+, Q21*.C, R132*.1, R133*.2
unnamed: C61*.+, R136*.1, R137*.2, R138*.1
unnamed: Q28*.B, R141*.2
unnamed: Q28*.C, R138*.2
unnamed: Q23*.B, R173*.2
unnamed: C63*.+, Q28*.E, R142*.1, R173*.1
unnamed: Q29*.E, R143*.1, R144*.1
unnamed: Q30*.E, R152*.1
unnamed: Q27*.E, R145*.1
unnamed: C71*.2, Q30*.B, R150*.2
unnamed: C67*.2, Q27*.B, R149*.2
unnamed: C65*.1, D13*.C, Q27*.C
unnamed: C66*.2, C68*.1, R147*.1
unnamed: C72*.2, C73*.1, R153*.1
unnamed: C68*.2, Q26*.B, R146*.1
OH_OUT: J4.2, R169*.2
TO_HH: C67*.1, C71*.1; also elsewhere on the board
TRIG_CH: R2*.2; also elsewhere on the board
TRIG_OH: R1*.2; also elsewhere on the board

Notes on the sheet:
HitHat

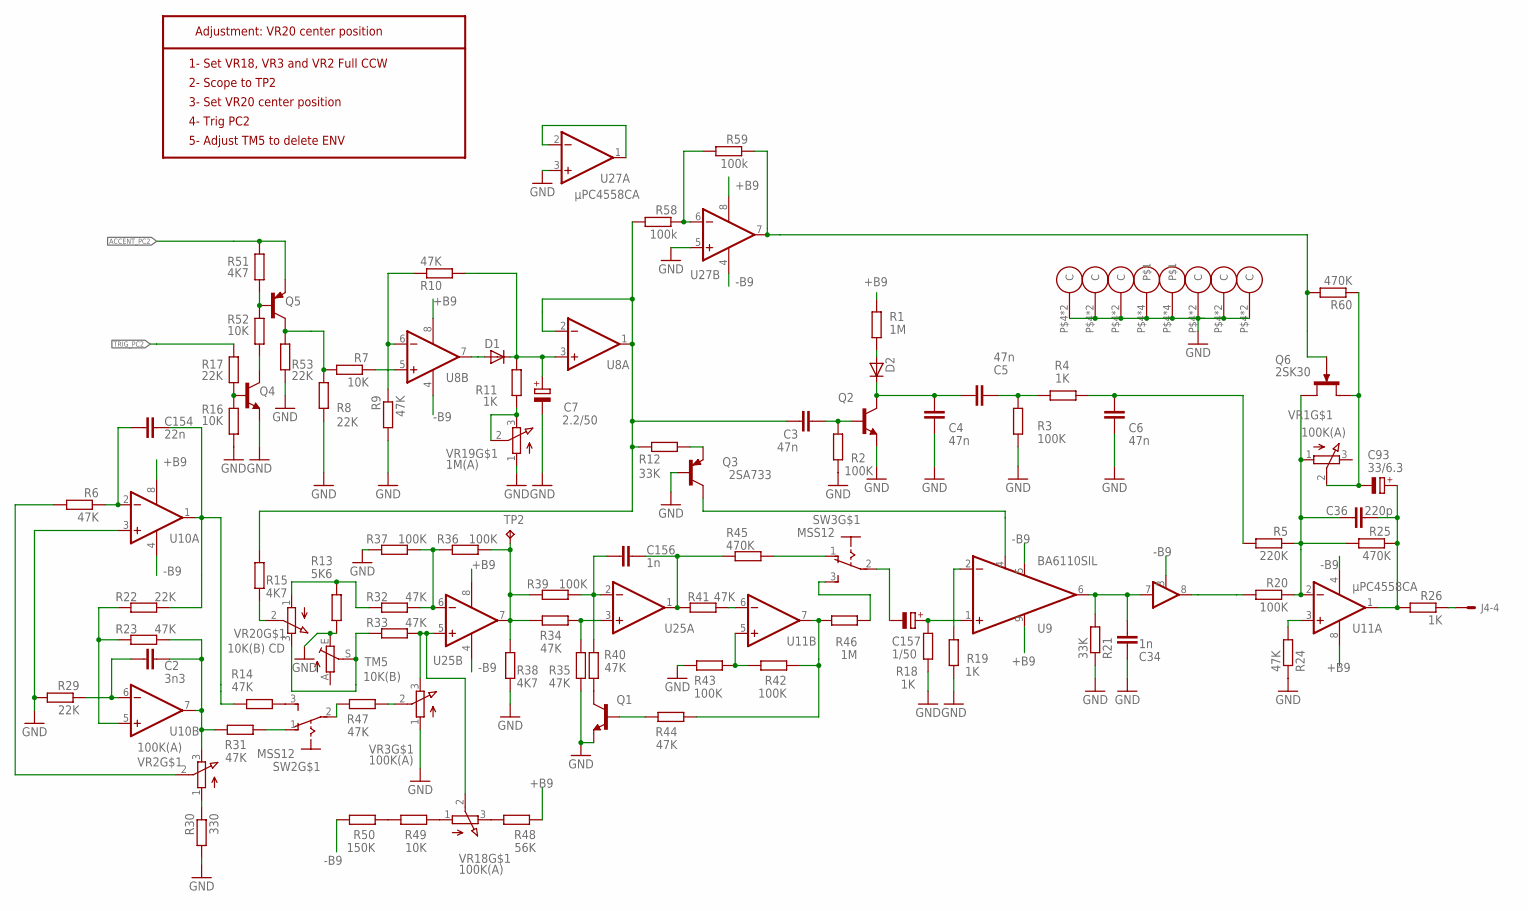
[picture p52: schematic Yocto v2.007.sch, sheet 17, PC-2]

Parts:
C2: 3n3; C050-025X075
C3, C4, C5, C6: 47n; C050-025X075
C7: 2.2/50; E2-5
C34, C156: 1n; C050-025X075
C36: 220p; C025-025X050
C93: 33/6.3; E2-5
C154: 22n; C050-025X075
C157: 1/50; E2-5
D1, D2: 1N4148; DO35-7C
J4: 22-27-2041-04; 6410-04
Q1, Q2, Q4: 2SC945; TO-92-ECB-PERSO
Q3, Q5: 2SA733; TO-92-ECB-MARKED
Q6: 2SK30; TO-92-MARKED_FET
R1, R46: 1M; 0207/7
R2, R3, R20, R36, R37, R39, R42, R43: 100K; 0207/7
R4, R11, R18, R19, R26: 1K; 0207/7
R5: 220K; 0207/7
R6, R9, R10, R14, R23, R24, R31, R32, R33, R34, R35, R40, R41, R44, R47: 47K; 0207/7
R7, R16, R49, R52: 10K; 0207/7
R8, R17, R22, R29, R53: 22K; 0207/7
R12, R21: 33K; 0207/7
R13: 5K6; 0207/7
R15, R38, R51: 4K7; 0207/7
R25, R45, R60: 470K; 0207/7
R30: 330; 0207/7
R48: 56K; 0207/7
R50: 150K; 0207/7
R58, R59: 100k; 0207/7
SW2, SW3: MSS12; MSS12_SW_SLIDE
TM5: 10K(B); CT6
TP2: TPB0,8; B0,8
U8, U10, U11, U25, U27: µPC4558CA; DIL08
U9: BA6110SIL; SIL09
VR1, VR2, VR3, VR18: 100K(A); R0903N
VR19: 1M(A); R0903N
VR20: 10K(B) CD; R0903N

Connections:
+B9: R1.1, R48.1, U8.8 (V+), U9.9 (V+), U10.8 (V+), U11.8 (V+), U25.8 (V+), U27.8 (V+); also elsewhere on the board
-B9: R50.2, U8.4 (V-), U9.3, U9.5 (V-), U10.4 (V-), U11.4 (V-), U25.4 (V-), U27.4 (V-); also elsewhere on the board
ACCENT_PC2: Q5.E, R51.2; also elsewhere on the board
CP_MA_OUT1: J4.4, R26.1
GND: C4.1, C6.1, C7.-, C34.1, Q1.E, Q2.E, Q3.B, Q4.E, R2.2, R3.2, R8.2, R9.2, R13.2, R16.1, R18.1, R19.1, R21.1, R24.1, R29.2, R30.2, R35.2, R37.2, R38.2, R43.1, R53.1, SW2.P$4, SW2.P$5, SW2.P$6, SW2.P$7, SW3.P$4, SW3.P$5, SW3.P$6, SW3.P$7, TM5.E, U10.3 (+IN), U27.3 (+IN), U27.5 (+IN), VR1.P$4 (C), VR1.P$5 (C), VR2.P$4 (C), VR2.P$5 (C), VR3.1 (A), VR3.P$4 (C), VR3.P$5 (C), VR18.P$4 (C), VR18.P$5 (C), VR19.1 (A), VR19.P$4 (C), VR19.P$5 (C), VR20.P$4 (C), VR20.P$5 (C); also elsewhere on the board
unnamed: D1.A, U8.7 (OUT)
unnamed: D2.A, R1.2
unnamed: Q1.C, R40.1
unnamed: C3.2, Q2.B, R2.1
unnamed: R24.2, U11.3 (+IN)
unnamed: C4.2, C5.2, D2.C, Q2.C
unnamed: C5.1, R3.1, R4.1
unnamed: C36.2, Q6.S, R5.1, R20.1, R25.2, U11.2 (-IN), VR1.1 (A)
unnamed: C6.2, R4.2, R5.2
unnamed: Q3.E, R12.1
unnamed: C36.1, C93.+, R25.1, R26.2, U11.1 (OUT)
unnamed: C7.+, D1.C, R10.2, R11.2, U8.3 (+IN)
unnamed: R7.1, U8.5 (+IN)
unnamed: R9.1, R10.1, U8.6 (-IN)
unnamed: R14.1, SW2.3 (S)
unnamed: C3.1, R12.2, R15.1, R58.2, U8.1 (OUT), U8.2 (-IN)
unnamed: R11.1, VR19.2 (S), VR19.3 (E)
unnamed: Q3.C, U9.4 (C)
unnamed: R15.2, VR20.2 (S)
unnamed: R13.1, R32.2, VR20.1 (A)
unnamed: R19.2, U9.2 (-IN)
unnamed: C34.2, R21.2, U9.6 (OUT), U9.7 (IN1)
unnamed: R20.2, U9.8 (OUT1)
unnamed: R33.2, TM5.S, VR20.3 (E)
unnamed: Q5.B, R51.1, R52.2
unnamed: C157.+, R18.2, U9.1 (+IN)
unnamed: Q4.B, R16.2, R17.1
unnamed: Q4.C, R52.1
unnamed: R34.1, R35.1, U25.3 (+IN)
unnamed: R34.2, R36.1, R38.1, R39.2, TP2.P$1, U25.7 (OUT)
unnamed: R32.1, R36.2, R37.1, U25.6 (-IN)
unnamed: R33.1, U25.5 (+IN), VR3.3 (E), VR18.2 (S)
unnamed: R41.1, U11.6 (-IN)
unnamed: C156.2, R39.1, R40.2, U25.2 (-IN)
unnamed: R42.2, R43.2, U11.5 (+IN)
unnamed: R47.1, VR3.2 (S)
unnamed: Q1.B, R44.2
unnamed: R42.1, R44.1, R46.2, U11.7 (OUT)
unnamed: R47.2, SW2.2
unnamed: R30.1, VR2.1 (A)
unnamed: R49.2, R50.1
unnamed: R49.1, VR18.1 (A)
unnamed: R48.2, VR18.3 (E)
unnamed: R31.1, SW2.1 (O)
unnamed: R45.1, SW3.1 (O)
unnamed: Q5.C, R7.2, R8.1, R53.2
unnamed: R58.1, R59.2, U27.6 (-IN)
unnamed: U27.1 (OUT), U27.2 (-IN)
unnamed: Q6.G, R59.1, R60.2, U27.7 (OUT)
unnamed: C93.-, Q6.D, R60.1, VR1.2 (S)
unnamed: C154.1, R14.2, R22.1, U10.1 (OUT)
unnamed: R22.2, R23.2, U10.5 (+IN)
unnamed: C2.2, R29.1, U10.6 (-IN)
unnamed: C2.1, R23.1, R31.2, U10.7 (OUT), VR2.3 (E)
unnamed: C154.2, R6.1, U10.2 (-IN)
unnamed: R6.2, VR2.2 (S)
unnamed: R46.1, SW3.3 (S)
unnamed: C156.1, R41.2, R45.2, U25.1 (OUT)
unnamed: C157.-, SW3.2
TRIG_PC2: R17.2; also elsewhere on the board

Notes on the sheet:
Adjustment: VR20 center position
1- Set VR18, VR3 and VR2 Full CCW
2- Scope to TP2
3- Set VR20 center position
4- Trig PC2
5- Adjust TM5 to delete ENV

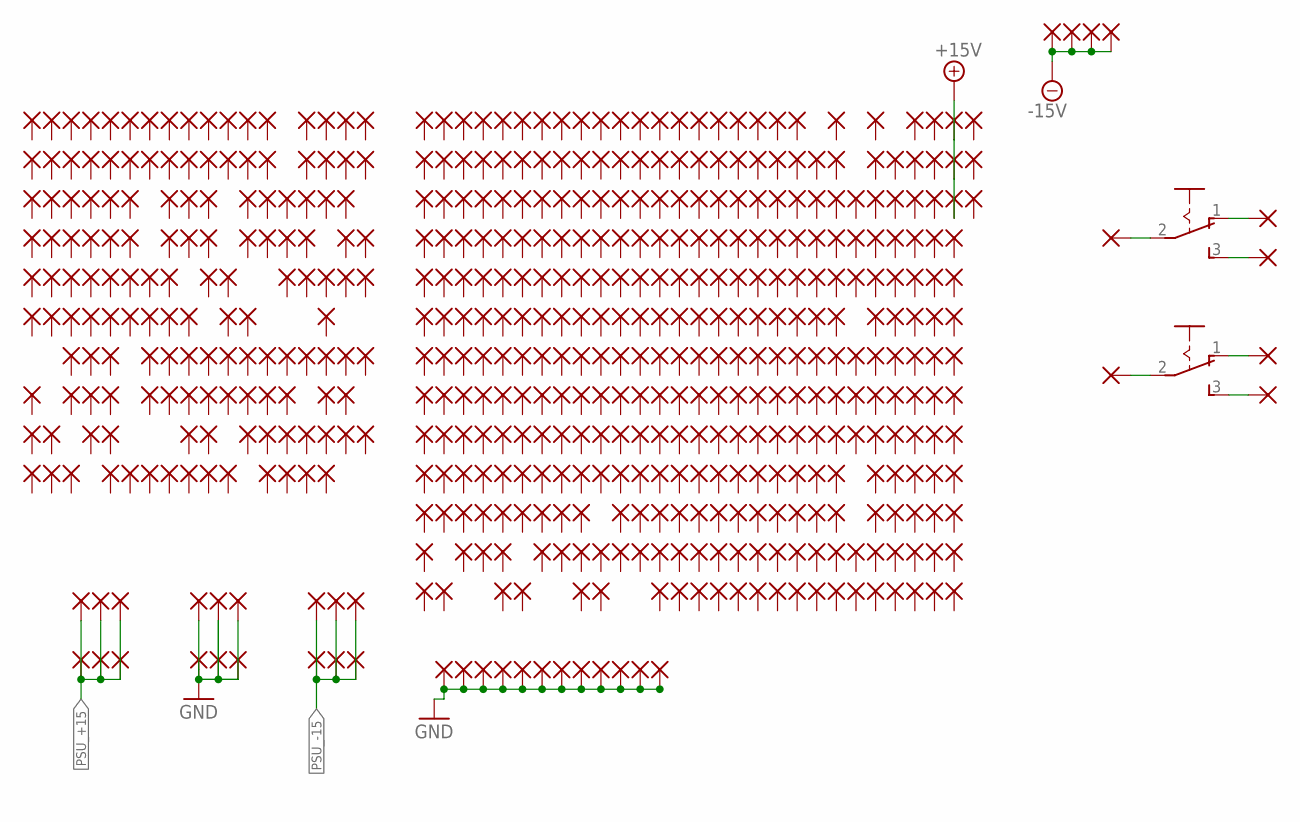
[picture p53: schematic Yocto v2.007.sch, sheet 18, Mods]

Parts:
MSW1, MSW2: MSS12; MSS12_SW_SLIDE
PAD1, PAD2, PAD3, PAD4, PAD5, PAD6, PAD7, PAD8, PAD9, PAD10, PAD11, PAD12, PAD13, PAD14, PAD15, PAD16, PAD17, PAD18, PAD19, PAD20, PAD21, PAD22, PAD23, PAD24, PAD25, PAD26, PAD27, PAD28, PAD29, PAD30, PAD31, PAD32, PAD33, PAD34, PAD35, PAD36, PAD37, PAD38, PAD39, PAD40, PAD41, PAD42, PAD43, PAD44, PAD45, PAD46, PAD47, PAD48, PAD49, PAD50, PAD51, PAD52, PAD53, PAD54, PAD55, PAD56, PAD57, PAD58, PAD59, PAD60, PAD61, PAD62, PAD63, PAD64, PAD65, PAD66, PAD67, PAD68, PAD69, PAD70, PAD71, PAD72, PAD73, PAD74, PAD75, PAD76, PAD77, PAD78, PAD79, PAD80, PAD81, PAD82, PAD83, PAD84, PAD85, PAD86, PAD87, PAD88, PAD89, PAD90, PAD91, PAD92, PAD93, PAD94, PAD95, PAD96, PAD97, PAD98, PAD99, PAD100, PAD101, PAD102, PAD103, PAD104, PAD105, PAD106, PAD107, PAD108, PAD109, PAD110, PAD111, PAD112, PAD113, PAD114, PAD115, PAD116, PAD117, PAD118, PAD119, PAD120, PAD121, PAD122, PAD123, PAD124, PAD125, PAD126, PAD127, PAD128, PAD129, PAD130, PAD131, PAD132, PAD133, PAD134, PAD135, PAD136, PAD137, PAD138, PAD139, PAD140, PAD141, PAD142, PAD143, PAD144, PAD145, PAD146, PAD147, PAD148, PAD149, PAD150, PAD151, PAD152, PAD153, PAD154, PAD155, PAD156, PAD157, PAD158, PAD159, PAD160, PAD161, PAD162, PAD163, PAD164, PAD165, PAD166, PAD167, PAD168, PAD169, PAD170, PAD171, PAD172, PAD173, PAD174, PAD175, PAD176, PAD177, PAD178, PAD179, PAD180, PAD181, PAD182, PAD183, PAD184, PAD185, PAD186, PAD187, PAD188, PAD189, PAD190, PAD191, PAD192, PAD193, PAD194, PAD195, PAD196, PAD197, PAD198, PAD199, PAD200, PAD201, PAD202, PAD203, PAD204, PAD205, PAD206, PAD207, PAD208, PAD209, PAD210, PAD211, PAD212, PAD213, PAD214, PAD215, PAD216, PAD217, PAD218, PAD219, PAD220, PAD221, PAD222, PAD223, PAD224, PAD225, PAD226, PAD227, PAD228, PAD229, PAD230, PAD231, PAD232, PAD233, PAD234, PAD235, PAD236, PAD237, PAD238, PAD239, PAD240, PAD241, PAD242, PAD243, PAD244, PAD245, PAD246, PAD247, PAD248, PAD249, PAD250, PAD251, PAD252, PAD253, PAD254, PAD255, PAD256, PAD257, PAD258, PAD259, PAD260, PAD261, PAD262, PAD263, PAD264, PAD265, PAD266, PAD267, PAD268, PAD269, PAD270, PAD271, PAD272, PAD273, PAD274, PAD275, PAD276, PAD277, PAD278, PAD279, PAD280, PAD281, PAD282, PAD283, PAD284, PAD285, PAD286, PAD287, PAD288, PAD289, PAD290, PAD291, PAD292, PAD293, PAD294, PAD295, PAD296, PAD297, PAD298, PAD299, PAD300, PAD301, PAD302, PAD303, PAD304, PAD305, PAD306, PAD307, PAD308, PAD309, PAD310, PAD311, PAD312, PAD313, PAD314, PAD315, PAD316, PAD317, PAD318, PAD319, PAD320, PAD321, PAD322, PAD323, PAD324, PAD325, PAD326, PAD327, PAD328, PAD329, PAD330, PAD331, PAD332, PAD333, PAD334, PAD335, PAD336, PAD337, PAD338, PAD339, PAD340, PAD341, PAD342, PAD343, PAD344, PAD345, PAD346, PAD347, PAD348, PAD349, PAD350, PAD351, PAD352, PAD353, PAD354, PAD355, PAD356, PAD357, PAD358, PAD359, PAD360, PAD361, PAD362, PAD363, PAD364, PAD365, PAD366, PAD367, PAD368, PAD369, PAD370, PAD371, PAD372, PAD373, PAD374, PAD375, PAD376, PAD377, PAD378, PAD379, PAD380, PAD381, PAD382, PAD383, PAD384, PAD385, PAD386, PAD387, PAD388, PAD389, PAD390, PAD391, PAD392, PAD393, PAD394, PAD395, PAD396, PAD397, PAD398, PAD399, PAD400, PAD401, PAD402, PAD403, PAD404, PAD405, PAD406, PAD407, PAD408, PAD409, PAD410, PAD411, PAD412, PAD413, PAD414, PAD415, PAD416, PAD417, PAD418, PAD419, PAD420, PAD421, PAD422, PAD423, PAD424, PAD425, PAD426, PAD427, PAD428, PAD429, PAD430, PAD431, PAD432, PAD433, PAD434, PAD435, PAD436, PAD437, PAD438, PAD439, PAD440, PAD441, PAD442, PAD443, PAD444, PAD446, PAD447, PAD448, PAD449, PAD450, PAD451, PAD452, PAD453, PAD454, PAD455, PAD456, PAD458, PAD459, PAD460, PAD461, PAD462, PAD463, PAD464, PAD465, PAD466, PAD467, PAD468, PAD470, PAD471, PAD472, PAD473, PAD474, PAD475, PAD476, PAD477, PAD478, PAD479, PAD480, PAD482, PAD483, PAD484, PAD485, PAD486, PAD487, PAD488, PAD489, PAD490, PAD491, PAD492, PAD494, PAD495, PAD496, PAD497, PAD498, PAD499, PAD500, PAD501, PAD502, PAD503, PAD506, PAD507, PAD508, PAD509, PAD510, PAD511, PAD512, PAD513, PAD514, PAD515, PAD518, PAD519, PAD520, PAD521, PAD522, PAD523, PAD524, PAD525, PAD526, PAD527, PAD530, PAD531, PAD532, PAD533, PAD534, PAD535, PAD536, PAD537, PAD538, PAD539, PAD542, PAD543, PAD544, PAD545, PAD546, PAD547, PAD548, PAD549, PAD550, PAD551: 1,6/0,8; 1.6/0.8ROUND

Connections:
+15V: PAD334.1, PAD335.1, PAD338.1; also elsewhere on the board
-15V: PAD287.1, PAD288.1, PAD292.1, PAD297.1; also elsewhere on the board
GND: PAD207.1, PAD213.1, PAD214.1, PAD220.1, PAD221.1, PAD227.1, PAD228.1, PAD241.1, PAD242.1, PAD261.1, PAD296.1, PAD301.1, PAD446.1, PAD458.1, PAD470.1, PAD475.1, PAD487.1, PAD499.1; also elsewhere on the board
unnamed: MSW1.1 (O), PAD326.1
unnamed: MSW1.3 (S), PAD327.1
unnamed: MSW2.1 (O), PAD330.1
unnamed: MSW2.3 (S), PAD331.1
unnamed: MSW2.2, PAD329.1
unnamed: MSW1.2, PAD328.1
PSU_+15: PAD410.1, PAD415.1, PAD422.1, PAD427.1, PAD434.1, PAD439.1; also elsewhere on the board
PSU_-15: PAD432.1, PAD494.1, PAD506.1, PAD518.1, PAD535.1, PAD547.1; also elsewhere on the board

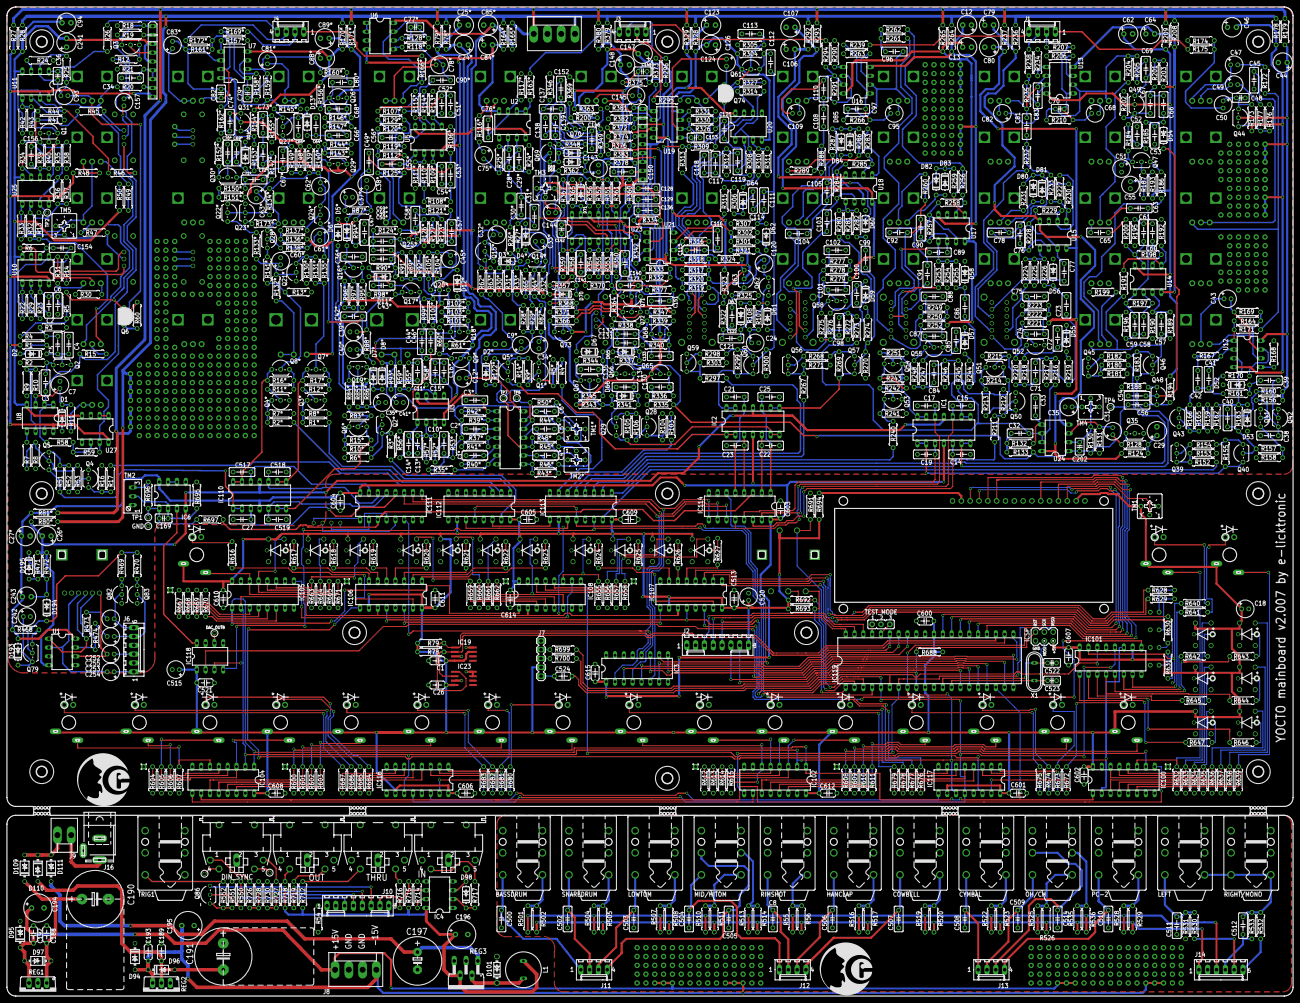
[picture p54: board Yocto v2.007.brd from above]

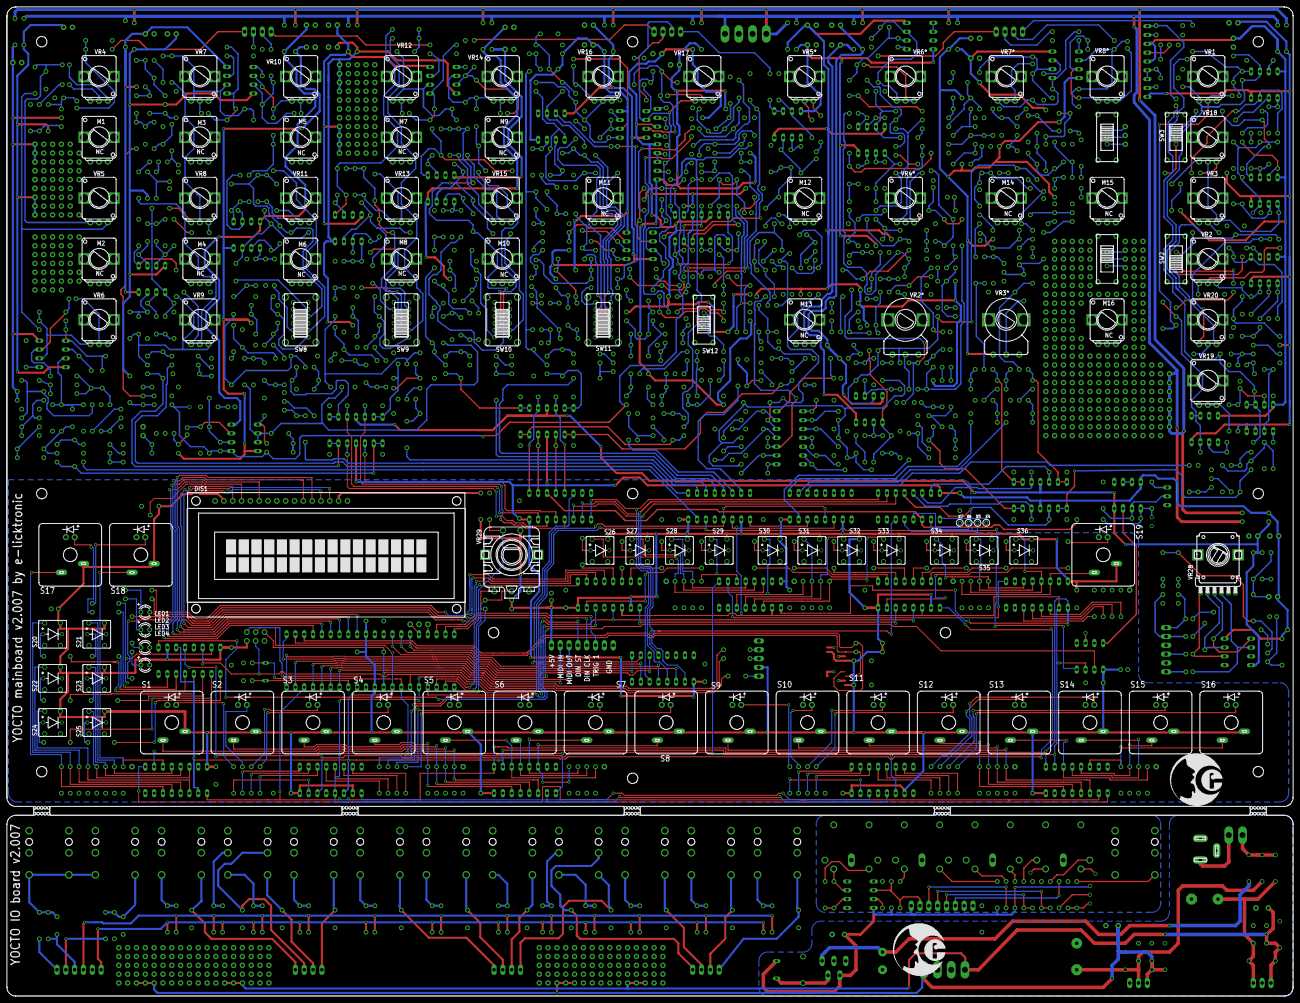
[picture p55: board Yocto v2.007.brd from below]

Board: 2 copper layers, 370.0 x 284.6 mm, 1765 parts (101 on the bottom side), 817 nets.

Other parts of the board:
U$1, U$13, U$14, U$15: LOGO_15MM_LITE
U$2, U$3, U$4, U$5, U$6, U$7, U$8, U$9, U$10, U$11, U$12: 3,0
