e-licktronic/Yocto-V2.0/Yocto_v2_003beta/Led.ino

//-------------------------------------------------
//                  Yocto v2.x
//              Sequencer Led
//-------------------------------------------------

////////////////////////Function//////////////////////

void SetLeds()
{
  //------------------------------Menu LEDS-------------------------------
  shiftLed = shiftBtn.pressed;
  instLed = instBtn;
  clearLed = clearBtn.pressed;
  shufLed = shufBtn.pressed;
  scaleLed = scaleBtn.pressed;
  lastStepLed = lastStepBtn.pressed ;
  if (isRunning){
    menuLed = LED_PLAY & ~LED_STOP | shiftLed<<1 | instLed<<2 | clearLed<<3 | shufLed<<4 | lastStepLed<<5 | scaleLed<<6 ;
    //stepLeds = pattern[ptrnBuffer].inst[curInst] ^ (blinkFast << curStep-1);
  }
  else{
    menuLed = (LED_PLAY*blinkTempo) | LED_STOP | shiftLed<<1 | instLed<<2 | clearLed<<3 | shufLed<<4 | lastStepLed<<5 | scaleLed<<6;
    //stepLeds = pattern[ptrnBuffer].inst[curInst] ^ (blinkTempo << curStep);
  }

  //------------------------------Config LEDS-------------------------------
  trackLed =((curSeqMode == TRACK_WRITE)? blinkTempo:((curSeqMode == TRACK_PLAY)? 1:0));
  ptrnLed =((curSeqMode == PTRN_STEP)? blinkTempo:((curSeqMode == PTRN_PLAY)? 1:0));
  tapLed =((curSeqMode == PTRN_TAP)? blinkTempo:((tapBtn.pressed) ? 1:0));
  if (keyboardMode){
    backLed = HIGH;
    fwdLed = HIGH;
  }
  else{
    backLed = backBtn.pressed;
    fwdLed = fwdBtn.pressed;
  }

  dirLed = dirBtn.pressed;
  scaleLeds = 1 << scaleBtn.counter;
  guideLed =  guideBtn.counter;
  if (curSeqMode == PTRN_STEP && curInst == EXT_INST) guideLed = blinkTempo;
  bankLed = bankBtn.pressed;

  if (instBtn && curInst == TOTAL_ACC) enterLed = HIGH;
  else if (patternNeedSaved || trackNeedSaved || seq.setupNeedSaved) enterLed = blinkTempo;
  else enterLed = LOW;

  if (curSeqMode == MUTE) muteLed = HIGH;
  else muteLed = LOW;

  if (seq.configMode) tempoLed = blinkTempo;
  else  tempoLed = tempoBtn.pressed;

  configLed = numLed | scaleLeds<<1 | trackLed<<5 | backLed<<6 | fwdLed<<7 | enterLed<<8 | ptrnLed<<9 | tapLed<<10 | dirLed<<11 |guideLed<<12 | bankLed<<13 | muteLed<<14 | tempoLed<<15;

  //------------------------------Step LEDS-------------------------------
  //Update inst selected Leds
  // if (curInst == TRIG_OUT | curInst == EXT_INST | curInst == TOTAL_ACC) curInst = 0;
  /* else*/  instSlctLed = (1 << curInst);

  /*  switch (curInst){
   case BD:
   instSlctLed = 0x01;
   break;
   case SD:
   instSlctLed = 0x02;
   break;
   case LT:
   instSlctLed = 0x04;
   break;
   case MT:
   instSlctLed = 0x08;
   break;
   case HT:
   instSlctLed = 0x10;
   break;
   case RM:
   instSlctLed = 0x20;
   break;
   case HC:
   instSlctLed = 0x40;
   break;
   case CB:
   instSlctLed = 0x80;
   break;
   case CY:
   instSlctLed = 0x8000;
   break;
   case OH:
   instSlctLed = 0x4000;
   break;
   case CH:
   instSlctLed = 0x3000;
   break;
   case PC2:
   instSlctLed = 0x3000;
   break;
   case TRIG_OUT:
   case EXT_INST:
   case TOTAL_ACC:
   instSlctLed = 0;//Clear step leds when TOTAL_ACC... selected
   break;
   }*/

  //Update step Leds depends sequencer Mode
  switch (curSeqMode){
    //------------------------------
    unsigned int temp;// tmep data of stepLeds;
  case TRACK_PLAY:
    if (isRunning) stepLeds = (1 << trk.current) ^ (blinkFast[curInst] << curStep[curInst]); 
    else stepLeds = blinkTempo << trk.current;
    break;
  case TRACK_WRITE:
    if (bankBtn.pressed){
      stepLeds = 1 << curBank;
    }
    else if (numBtn.pressed){
      stepLeds = 1 << trk.current;
    }
    else{
      if (isRunning) stepLeds = (1 <<(curPattern % NBR_PATTERN)) ^ (blinkFast[curInst] << curStep[curInst]); 
      else stepLeds = blinkTempo << (curPattern % NBR_PATTERN); 
    }
    break;
    //------------------------------
  case PTRN_PLAY:
    if (bankBtn.pressed){
      stepLeds = 1 << curBank;
    }
    else{
      if (isRunning){
        if (group.length){
          temp = 0;
          for (int a = 0; a <= group.length; a++){
            bitSet(temp,(group.firstPattern % NBR_PATTERN) + a);
          }
          stepLeds = temp & ~(!blinkTempo << (nextPattern % NBR_PATTERN))  ^ (blinkFast[curInst] << curStep[curInst]);
        }
        else {
          stepLeds = (blinkTempo <<(nextPattern % NBR_PATTERN)) ^ (blinkFast[curInst] << curStep[curInst]); 
        }
      }
      else if (!isRunning){
        // if (group.length){
        temp = 0;
        //Serial.println(group.length);
        for (int a = 0; a <= group.length; a++){
          bitSet(temp,(group.firstPattern % NBR_PATTERN) + a);
        }
        stepLeds = temp & ~(!blinkTempo << (nextPattern % NBR_PATTERN));
        /* }
         else {
         stepLeds = blinkTempo << (curPattern % NBR_PATTERN); 
         }*/
      }
    }
    break;
    //------------------------------
  case PTRN_STEP:
    //display selected inst on steps Leds
    if (instBtn){
      if(flagLedIntensity >= 8){
        stepLeds = instSlctLed ;
        flagLedIntensity = 0;
      }
      else{
        stepLeds = instSlctLed & LED_MASK;
        flagLedIntensity++;
      }
    }
    else if(isRunning && !instBtn){
      stepLedsHigh = stepLedsLow = 0;//initialize step Leds variable 
      for (int stp = 0; stp < NBR_STEP; stp++){
        if (pattern[ptrnBuffer].velocity[curInst][stp] > instVelLow[curInst] && bitRead(pattern[ptrnBuffer].inst[curInst],stp)) bitSet(stepLedsHigh, stp);
        else if (pattern[ptrnBuffer].velocity[curInst][stp] <= instVelLow[curInst] && bitRead(pattern[ptrnBuffer].inst[curInst],stp)) bitSet(stepLedsLow,stp);
        else { 
          bitClear(stepLedsHigh, stp);   
          bitClear(stepLedsLow, stp); 
        }
      }
      //this function is to fade low velocity leds
      if(flagLedIntensity >= 8){
        stepLeds = stepLedsHigh | stepLedsLow ^ blinkFast[curInst] << curStep[curInst];//B1111111111111111;
        flagLedIntensity = 0;
      }
      else{
        stepLeds = stepLedsHigh ^ blinkFast[curInst] << curStep[curInst];//B1010101010101010;
        flagLedIntensity++;
      }
    }
    else if (!isRunning && !instBtn){
      //Display Bank number
      if (bankBtn.pressed){
        stepLeds = 1 << curBank;
      }
      //display selected pattern
      else{
        // if (group.length)
        temp = 0;
        // Serial.println(group.length);
        for (int a = 0; a <= group.length; a++){
          bitSet(temp,(group.firstPattern % NBR_PATTERN) + a);
        }
        stepLeds = temp & ~(!blinkTempo << (curPattern % NBR_PATTERN));
      }
    }
    break;
  case PTRN_TAP:
    stepLeds = stepValue;//(pattern[ptrnBuffer].step[globalStepCount] * blinkFast) ;
    break;
    //------------------------------
  case MUTE:
    stepLeds = muteInst ^ stepValue;
    //if (encBtn.pressed) muteLeds = 0;
    break;
  }
  //Send OUTPUTS now !
  SetDoutLed(stepLeds, configLed , menuLed);
}
