e-licktronic/Yocto-V2.0/Yocto_v2_003beta/Trig.ino

//-------------------------------------------------
//                  Yocto v2.x
//                 Trig.c
//-------------------------------------------------

////////////////////////Function//////////////////////

void SetTrigTime()
{
   if (trig1State && !trigTimeOk){
    trigTime = millis();
    trigTimeOk = HIGH;
  }
  if (millis() - trigTime >= TRIG_TIME_MS){
    TR1_HIGH;//Reset trig1 out
    trig1State = trigTimeOk = LOW;
  }
}
